name718/drone/文档/桌面自平衡机器人2/图片/02-TB6612电机驱动模块.png

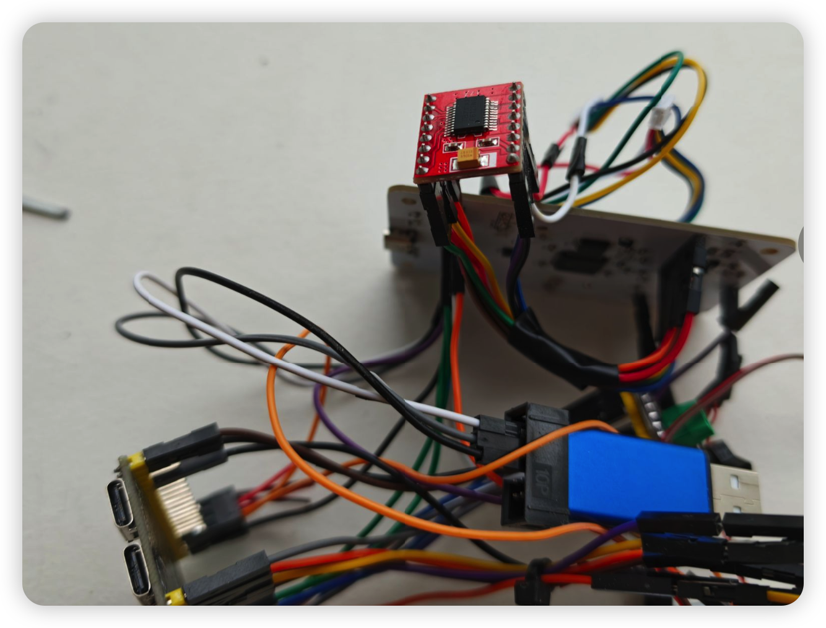
文档/桌面自平衡机器人2/图片/02-TB6612电机驱动模块.png
