name718/drone/文档/桌面自平衡机器人2/图片/05-N20编码器电机与主控板.png

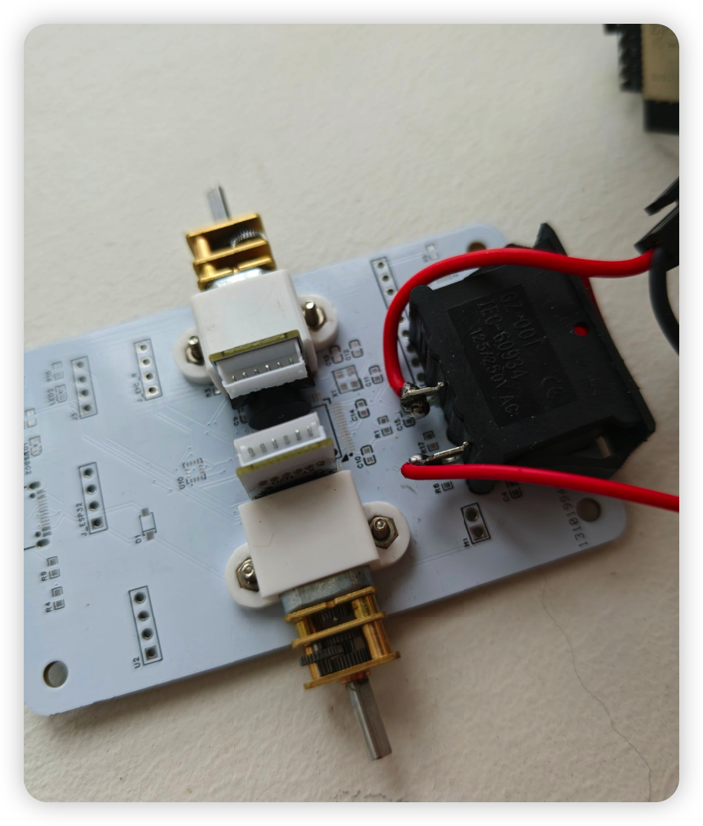
文档/桌面自平衡机器人2/图片/05-N20编码器电机与主控板.png
