name718/drone/文档/桌面自平衡机器人2/图片/README.md

# 硬件实物照片

| 文件 | 内容 |
| --- | --- |
| `01-硬件全景.png` | 当前硬件与接线整体照片 |
| `02-TB6612电机驱动模块.png` | TB6612 电机驱动模块及周边接线 |
| `03-LM2596降压模块.png` | LM2596 降压模块正面 |
| `04-ESP32-S3开发板.png` | ESP32-S3 双 USB-C 开发板 |
| `05-N20编码器电机与主控板.png` | N20 编码器电机、轮子和主控板局部 |
| `06-主控板及音频模块.png` | 主控板、排针模块及音频相关模块局部 |

照片用于器件识别和装配记录；由于拍摄角度和比例尺限制，不作为精确尺寸测量依据。
