name718/drone/代码文档/查缺补漏.md

# const_cast
# constexpr

# pdMS_TO_TICKS
> 作用是将人类习惯的“毫秒（ms）”时间转换为操作系统内核运行所用的“系统节拍数（Ticks）”。

# explicit

# I2S

# DMA

# using CommandCallback = std::function<void(VoiceCommand)>;
