name718/drone/文档/桌面自平衡机器人2/10-硬件尺寸总表.md

# 桌面自平衡机器人 2.0 硬件尺寸总表

> 更新日期：2026-10-17  
> 用途：集中记录 2.0 机械建模所需的硬件尺寸。单位均为 mm；“已确认”优先作为 CAD 输入，“待复核/待测”不可当作最终加工尺寸。

## 1. 已有尺寸

| 部件 | 尺寸 / 参数 | 来源与状态 | CAD 使用建议 |
| --- | --- | --- | --- |
| 橡胶车轮（白色轮毂、黑色胎） | 外径 Ø43.36；宽 17.64 | 游标卡尺实测 | 采用实测值；轮毂轴孔仍待测 |
| 2S 18650 电池组 | 71.60 × 37.30 × 22.10 | 游标卡尺实测 | 采用实测最大包络；托架每侧额外留 1.5–2.0 间隙；线束另留空间 |
| STM32 主控 PCB | 外形 53.987 × 85.587 × 1.600；四角圆弧约 R3.987 | STEP 文件 `3D_PCB1_2026-10-17.step` 中 PCB 本体实体 | 以 STEP 模型为准；外形可按 53.99 × 85.59 × 1.60 建模 |
| STM32 主控 PCB 安装孔 | 4 × Ø3.200；中心坐标约 (5.00, 4.00)、(50.00, 4.00)、(5.00, 81.60)、(50.00, 81.60)；孔距 45.00 × 77.60；中心距板边约 4.00 | 同一 STEP 文件；相对板框坐标，原点方向依导出坐标系 | 以孔距和边距定位支柱；建模前核实 STEP 的坐标原点/板边方向 |
| 主控 PCB 元件总包络 | STEP 全模型包围范围约 X 66.69 × Y 96.57 × Z 15.61 | STEP 所有几何点的总体范围，包含外伸连接器/引脚及器件模型 | 仅用于装配净空参考，不作为裸 PCB 尺寸；边缘插头需额外留插拔空间 |
| 主控 PCB 标准排针 | 2.54 间距；J2 为 1×10；J_ENC_L、J_ENC_R、J_ESP32、J3 为 1×4 | PCB 坐标导出文本与 STEP 模型 | 针位已知；排针总高度与配套插头外形尚未核实 |
| 船型电源开关 KCD1 / GZ-001 | 面板外框 31.20 × 13.70 | 游标卡尺实测 | 该值不是面板开孔尺寸；开孔和背部深度待测 |
| N20 电机支架 | 外宽 17.20；纵深约 11–12；高度约 14.50；单支架孔中心距约 17.50–18.00；左右支架横向跨度约 39.50 | 外宽、跨度为用户实测；其他为标准件参考/照片估算 | CAD 可暂用 18.00 孔距；打印/加工前需复测孔距、孔径、纵深、高度和电机轴中心高度 |
| N20 编码器减速电机（图示 12GA-N20 套装） | 标准 N20 齿轮箱正面约 **12 × 10 mm**；电机+齿轮箱本体长度随减速比/尾盖变化，常见约 **26–32 mm**；编码器尾板另增加约 **5–10 mm**；输出轴常见 Ø3 mm D 轴 | 图片确认是 12GA-N20 带编码器套装；12GA 是商品/套装名，不足以唯一确定减速比和尾板尺寸 | 外宽可参考 12 × 10；总长及轴伸出没有该商品工程图，不能用单一数值冻结 |
| N20 配套轮毂 | 项目轮胎实测 Ø43.36 × 17.64；配套轮常见 3 mm D 轴孔，但轮毂深度/偏置随白色轮毂版本变化 | 图片能确认白色轮毂配黑胎；未提供轴孔尺寸图或比例尺 | 外形采用实测；轴孔“3 mm D 孔”仅作候选，孔深和偏置目前仍未知 |
| TB6612FNG 双路电机驱动模块（红色小板） | 照片可确认红色 TB6612FNG breakout 类型；同芯片载板有约 **20 × 20 mm** 到 **25 × 20 mm** 等多种板框，芯片本身封装约 **9.7 × 6.4 mm** | 图片没有可辨识的板号/商品型号；裸芯片封装尺寸可查，载板尺寸不统一 | 不将通用载板尺寸当作本板尺寸；板框、孔位和板厚需要对应卖家图纸或实物卡尺值 |
| ESP32-S3 双 USB-C 开发板 | 图片显示双 USB-C 的 ESP32-S3 DevKitC 类板；官方 DevKitC-1 PCB 参考外形约 **55 × 28 mm**、PCB 厚约 1.6 mm | 图片可辨识双 USB-C 板型家族，但不能确认是 Espressif 官方板还是兼容板 | 官方 DevKitC-1 数值只作近似参考；兼容板 USB 外壳/板边可能不同，孔位不可直接套用 |
| Luckfox Pico Mini A/B（RV1103） | 官方 Pico Mini 板型约 **30 × 30 mm** | 商品图确认 Pico Mini A/B、RV1103；官方系列板型资料 | PCB 外形可按 30 × 30 mm 参考；板厚、焊接排针总高、接口凸出和安装孔依实际版本确认 |
| OV5640 自动对焦 DVP 模块（蓝色 Gravity 类板） | 同类 Gravity 板常见约 **32 × 32 mm**；镜头模组直径约 **8–10 mm**，镜头高度依焦距/对焦座版本变化 | 图片确认是蓝色 Gravity 风格 OV5640 自动对焦模块；没看到商品机械图，镜头版本不唯一 | 32 × 32 mm 仅为板框参考；本图两个安装孔、光轴偏置、镜头高度不能从无比例尺照片量准 |
| SG90 双自由度云台套件 | 标准 SG90 舵机本体常见约 **23 × 12.2 × 29 mm**；图示云台含两个舵机、底座和塑料支架，整套总包络没有统一尺寸 | 图片确认是 9g SG90 pan-tilt 套件；不同商家支架版本不同 | 舵机本体可参考标准尺寸；云台支架总长宽高/底孔距不从相似商品推定 |
| ST7735S 1.8 英寸 TFT 模块 | 1.8 英寸 128×160 屏的有效显示区约 **28.0 × 35.0 mm**；模块 PCB 常见外框存在约 **35 × 35 mm**、**35 × 50 mm** 等不同版本 | 项目记录确认 1.8 英寸 ST7735S；实物照显示屏装在白色承载板/总成中，无法从照片分离出屏模块 PCB 外框 | 显示区按分辨率/对角规格参考；模块板框、厚度、孔位和排针朝向必须按实际模块图纸确认 |
| LM2596 类降压模块 | PCB 长 56.80 × 宽 23.80 | 游标卡尺实测 | 板面占位可先采用；最高元件高度、安装孔位、端子/电位器净空待测 |

## 2. 尚缺的尺寸

| 部件 | 需要补充的测量项 | 用途 / 优先级 |
| --- | --- | --- |
| N20 电机本体 | 网上已有 N20 参考包络；仍需核对本批次总长、输出轴伸出量、轴中心高度、编码器尾部和左右一致性 | 高：网上尺寸可作初版，实物决定最终配合 |
| 车轮 | 网上常见 3 mm D 孔；仍需核对本轮毂孔径、D 轴平面尺寸/孔深和轮毂偏置 | 高：确认轴适配和轮距 |
| N20 支架 | 安装孔实际孔径、中心距、支架纵深和高度、板厚/折弯尺寸 | 高：锁定电机安装孔 |
| 电池组 | 插头及平衡线从电池壳体伸出后的方向、总长度；保护板或壳体局部凸起 | 高：电池托架与线束净空 |
| 主控 PCB | STEP 坐标中 USB-C/排针插接方向；线束和插头插拔空间 | 中高：确保装好后可维护 |
| LM2596 模块 | 安装孔中心坐标/孔径；最大高度；端子、散热片、电位器突出尺寸 | 中高：确定托板与固定方式 |
| TB6612FNG 模块 | 红色载板尺寸没有通用标准；需要对应商品图纸或实物板框、板厚、排针高度 | 中：照片只能确认芯片/载板类别 |
| ESP32-S3 开发板 | 官方 DevKitC-1 有约 55 × 28 mm 参考；仍需确认照片中兼容板的板框、排针总高和 USB 凸出 | 中：实际板型未由照片唯一确定 |
| ST7735S 屏幕 | 1.8 英寸有效显示区约 28 × 35 mm；实际 PCB 板框/厚度/孔位依模块版本 | 中：实物照无法分离显示模块与白色承载板 |
| 双轴云台与 SG90 | SG90 本体网上已有 23 × 12.2 × 29 mm 参考；云台套件总长/总宽/总高、底板孔距、机械限位仍待确认 | 中高：头部活动包络及线束余量 |
| INMP441 / MAX98357A | 模块长宽厚、安装孔、排针高度和线缆方向 | 中：托板布局 |
| 3525 扬声器 | 外径、最大厚度、安装孔距/孔径、出线方向 | 中：头部开孔和固定 |
| OV5640 摄像头 | 同类 Gravity 板框约 32 × 32 mm 仅作参考；核实实际板框、镜头突出和孔位 | 高：照片无尺标，不能确定到具体尺寸 |
| Luckfox Pico Mini A/B | 官方约 30 × 30 mm 板框参考；核实厚度、排针高、接口凸出和具体版本 | 高：新增计算板安装 |
| VL53L0X（若纳入） | 模块板外形、安装孔和光学窗口位置 | 低：当前为待确认扩展件 |
| 船型开关 | 面板开孔尺寸、卡扣外形、允许板厚、背部深度 | 中：开关面板开孔 |
| 紧固件/尼龙柱 | 螺纹、杆长、头径/六角对边、螺母厚度、尼龙柱总长 | 中：装配间隙和层间距 |

## 3. 建模基准与注意事项

- 主控 PCB 所有外形和安装孔数据以 STEP 模型为准；此前卡尺记录的 85.40 × 49.00 mm 不作为 CAD 基准。
- PCB STEP 全模型包围盒包含元件和外伸结构，不能拿 66.69 × 96.57 mm 作为板框尺寸。
- 电池托架依据实测最大包络建模；电池导线、插头、平衡线不包含在 71.60 × 37.30 × 22.10 mm 中。
- 支架 18 mm 孔距当前是近似值。正式打印前量孔中心距和孔径，并确认螺丝实际规格；不能只依据照片推算。
- 元件清单及安装状态见 [09-2.0升级方案与硬件建模测量清单](09-2.0升级方案与硬件建模测量清单.md)。暂停的四轴无人机尺寸资料不并入本表。

## 4. 网上规格参考入口

- N20：按 `12GA-N20 编码器减速电机`、`N20 gear motor mechanical drawing` 类目规格整理；减速比、编码器尾盖和轮子套装会改变总长。
- ESP32-S3：Espressif [ESP32-S3-DevKitC-1](https://docs.espressif.com/projects/esp-idf/en/latest/esp32/hw-reference/esp32s3/user-guide-devkitc-1.html) 机械外形作为官方板型参考。
- Luckfox：Luckfox [Pico Mini RV1103](https://wiki.luckfox.com/Luckfox-Pico/Luckfox-Pico-RV1103/) 系列资料作为板型参考。
- OV5640：按 `OV5640 DVP autofocus module` / Gravity 类模块商品机械尺寸整理；镜头和转接板不是统一标准件。
- SG90：按 TowerPro SG90/9g servo 通用机械尺寸整理；仿品外壳尺寸可能不同。
- ST7735S：按常见 `1.8 inch 128×160 ST7735S SPI module` 商品板型整理。
- TB6612FNG：按常见红色 breakout 模块整理；Pololu、SparkFun 和国产载板不是同一 PCB 尺寸。

## 5. 实测记录模板

```text
部件：
测量项：
数值（mm）：
测量位置/方向：
是否包含插头、排针、线束或凸出元件：
测量工具与备注：
```
