name718/drone/文档/桌面自平衡机器人/05-V1主控板原理图与全量网表规范.md

# 桌面双轮自平衡智能机器人主控板 · V1 原理图全量规范与引脚级网表

> **版本**：V1.0 (生产定稿版)  
> **对应图纸**：`桌面自平衡机器人/原理图/SCH_Schematic1_1-P1_2026-08-27.png`  
> **文档目的**：本规范以严格、结构化、无歧义的文字形式完整描述整张主控板原理图。包含**引脚级元件网表、全局网络连接清单、单片机外设映射字典与 PCB/固件开发规范**，可直接投喂给其他 AI Agent 进行 PCB 自动布线或嵌入式底层固件开发。

---

## 1. 硬件系统整体架构概述

```text
┌─────────────────────────────────────────────────────────────────────────────────┐
│                           2S 动力锂电池组 (7.4V ~ 8.4V)                         │
└────────┬───────────────────────────────────────────────────────┬────────────────┘
         │                                                       │
                                                               
┌──────────────────┐                                   ┌──────────────────┐
│ J1: 电池供电输入 │                                   │ 外部 LM2596S     │
└────────┬─────────┘                                   │ 降压模块 (6.0V)  │
         │ VBAT                                        └────────┬─────────┘
         ├───────────────────────┬──────────────────┐           │ VM_6V
                                                          
┌──────────────────┐   ┌──────────────────┐   ┌───────────────────────────────────┐
│ U11: SY8120IABC  │   │ 电池分压采样     │   │ H1 / J_TB: 动力驱动接口 (1x10P)   │
│ 2S降压DCDC (2A)  │   │ R8(10k)+R17(4.7k)│   │ • VM_6V 独立供电                   │
└────────┬─────────┘   └────────┬─────────┘   │ • TB6612FNG 双路 H 桥模块         │
         │ +5V                  │ BAT_SENSE   │ • 驱动 2 颗 N20 减速电机 (6V)     │
         ├───────────────┐      │ (0~2.68V)   └───────────────────────────────────┘
         │               │                                     
                       │   ┌───────────────────────────────┐   │ PWM/DIR/STBY
┌──────────────────┐     │   │                               │───┘
│ LDO2: ME6211C33  │     │   │    U9: STM32G473RCT6 主控     │
│ 5V 转 3.3V (LDO) │     │   │   (LQFP-64, 170MHz Cortex-M4) │───┐
└────────┬─────────┘     │   │                               │   │
         │ +3V3          │   └──────┬─────────────────┬──────┘   │
                                │ SPI1            │ SPI2     │
┌──────────────────────────────┐                             │
│ • U9 STM32G473 单片机电源    │ ┌──────────────┐ ┌────────────┐ │
│ • U10 ICM-42605 6轴陀螺仪    │ │ U10: 6轴 IMU │ │ U13: Flash │ │
│ • U13 W25Q128 Flash 存储器   │ │  ICM-42605   │ │  W25Q128   │ │
│ • J_ENC_L/R 左右轮霍尔编码器 │ └──────────────┘ └────────────┘ │
│ • USBC2 Type-C 与 SWD 调试口 │                                 │
└──────────────────────────────┘                                 │
                                                               │
         │ USB_VBUS (通过 D1 肖特基二极管供电)                   │ USART2 串口
         │                                                       
┌──────────────────┐                                   ┌──────────────────┐
│ USBC2: Type-C 口 │                                   │ J_ESP32: AI 大脑 │
│ 电脑插线调试/下载│                                   │ ESP32-S3 智能板  │
└──────────────────┘                                   └──────────────────┘
```

---

## 2. 芯片级引脚连接与网表定义 (Pin-to-Net Definition)

### 2.1 U9：主控 MCU (STM32G473RCT6, LQFP-64)

| 引脚编号 | 引脚名称 | 连接网络 (Net Name) | 硬件外设功能 / 目标连接 |
| :---: | :--- | :--- | :--- |
| **1** | `VBAT` | `+3V3` | 备用电源域供电，接系统 3.3V |
| **2** | `PC13` | `LED_STATUS` | 用户状态指示灯（低电平点亮蓝色 LED2） |
| **3** | `PC14-OSC32_IN` | `NC` (打叉) | 未使用，悬空隔离 |
| **4** | `PC15-OSC32_OUT`| `NC` (打叉) | 未使用，悬空隔离 |
| **5** | `PF0-OSC_IN` | `PF0-OSC_IN` | 8MHz 主晶振输入端，接 X1 第 1 脚及 C12 (15pF) |
| **6** | `PF1-OSC_OUT` | `PF1-OSC_OUT` | 8MHz 主晶振输出端，接 X1 第 3 脚及 C13 (15pF) |
| **7** | `PG10-NRST` | `NRST` 节点 | 硬件复位：接 R1 (10k 上拉到 +3V3) 及 C14 (100nF 到 GND) |
| **8** | `PC0` | `BAT_SENSE` | ADC1 通道，采集电池分压（10k + 4.7k 分压点） |
| **9** | `PC1` | `NC` (打叉) | 未使用，悬空隔离 |
| **10** | `PC2` | `NC` (打叉) | 未使用，悬空隔离 |
| **11** | `PC3` | `NC` (打叉) | 未使用，悬空隔离 |
| **12** | `PA0` | `ENC_L_A` | TIM2_CH1：左轮霍尔编码器 A 相输入 |
| **13** | `PA1` | `ENC_L_B` | TIM2_CH2：左轮霍尔编码器 B 相输入 |
| **14** | `PA2` | `STM_TX` | USART2_TX：串口发送至 ESP32-S3 (RX) |
| **15** | `VSS` | `GND` | 数字地 1 |
| **16** | `VDD` | `+3V3` | 数字核心供电 1，就近放 100nF 去耦电容 |
| **17** | `PA3` | `STM_RX` | USART2_RX：串口接收来自 ESP32-S3 (TX) |
| **18** | `PA4` | `IMU_CS` | SPI1_NSS：ICM-42605 陀螺仪片选信号 (片选有效为低) |
| **19** | `PA5` | `IMU_SCK` | SPI1_SCK：ICM-42605 陀螺仪时钟线 |
| **20** | `PA6` | `IMU_MISO` | SPI1_MISO：ICM-42605 陀螺仪数据输入 |
| **21** | `PA7` | `IMU_MOSI` | SPI1_MOSI：ICM-42605 陀螺仪数据输出 |
| **22** | `PC4` | `IMU_INT1` | EXTI4：ICM-42605 姿态数据就绪硬件中断引脚 |
| **23** | `PC5` | `NC` (打叉) | 未使用，悬空隔离 |
| **24** | `PB0` | `MOTOR_BIN2` | GPIO 输出：右轮电机方向控制信号 2 |
| **25** | `PB1` | `MOTOR_STBY` | GPIO 输出：TB6612 驱动使能信号（带 10k 下拉到 GND） |
| **26** | `PB2` | `NC` (打叉) | 未使用，悬空隔离 |
| **27** | `VSSA` | `GND` | 模拟地 |
| **28** | `VREF+` | `+3V3` | ADC 模拟参考电压正极 |
| **29** | `VDDA` | `+3V3` | 模拟供电正极，放 100nF 去耦电容 |
| **30** | `PB10` | `NC` (打叉) | 未使用，悬空隔离 |
| **31** | `VSS` | `GND` | 数字地 2 |
| **32** | `VDD` | `+3V3` | 数字核心供电 2，放 100nF 去耦电容 |
| **33** | `PB11` | `NC` (打叉) | 未使用，悬空隔离 |
| **34** | `PB12` | `FLASH_CS` | SPI2_NSS：W25Q128 Flash 芯片片选信号 |
| **35** | `PB13` | `FLASH_SCK` | SPI2_SCK：W25Q128 Flash 时钟线 |
| **36** | `PB14` | `FLASH_MISO` | SPI2_MISO：W25Q128 Flash 数据输入 |
| **37** | `PB15` | `FLASH_MOSI` | SPI2_MOSI：W25Q128 Flash 数据输出 |
| **38** | `PC6` | `MOTOR_PWMA` | TIM3_CH1 / TIM8_CH1：左轮电机 PWM 调速输出 |
| **39** | `PC7` | `MOTOR_PWMB` | TIM3_CH2 / TIM8_CH2：右轮电机 PWM 调速输出 |
| **40** | `PC8` | `MOTOR_AIN1` | GPIO 输出：左轮电机方向控制信号 1 |
| **41** | `PC9` | `MOTOR_AIN2` | GPIO 输出：左轮电机方向控制信号 2 |
| **42** | `PA8` | `ENC_R_A` | TIM1_CH1：右轮霍尔编码器 A 相输入 |
| **43** | `PA9` | `ENC_R_B` | TIM1_CH2：右轮霍尔编码器 B 相输入 |
| **44** | `PA10` | `NC` (打叉) | 未使用，悬空隔离 |
| **45** | `PA11` | `USB_DM` | USB_FS_DM：Type-C USB 数据负端 |
| **46** | `PA12` | `USB_DP` | USB_FS_DP：Type-C USB 数据正端 |
| **47** | `VSS` | `GND` | 数字地 3 |
| **48** | `VDD` | `+3V3` | 数字核心供电 3，放 100nF 去耦电容 |
| **49** | `PA13` | `SWDIO` | SWD 调试数据线，接 U2 烧录排针第 2 脚 |
| **50** | `PA14` | `SWCLK` | SWD 调试时钟线，接 U2 烧录排针第 3 脚 |
| **51** | `PA15` | `MOTOR_BIN1` | GPIO 输出：右轮电机方向控制信号 1 |
| **52** | `PC10` | `NC` (打叉) | 未使用，悬空隔离 |
| **53** | `PC11` | `NC` (打叉) | 未使用，悬空隔离 |
| **54** | `PC12` | `NC` (打叉) | 未使用，悬空隔离 |
| **55** | `PD2` | `NC` (打叉) | 未使用，悬空隔离 |
| **56** | `PB3` | `NC` (打叉) | 未使用，悬空隔离 |
| **57** | `PB4` | `NC` (打叉) | 未使用，悬空隔离 |
| **58** | `PB5` | `NC` (打叉) | 未使用，悬空隔离 |
| **59** | `PB6` | `NC` (打叉) | 未使用，悬空隔离 |
| **60** | `PB7` | `NC` (打叉) | 未使用，悬空隔离 |
| **61** | `PB8-BOOT0`| `BOOT0` 节点 | 启动模式配置：接 R3 (10k 下拉到 GND) 默认 Flash 启动 |
| **62** | `PB9` | `NC` (打叉) | 未使用，悬空隔离 |
| **63** | `VSS` | `GND` | 数字地 4 |
| **64** | `VDD` | `+3V3` | 数字核心供电 4，放 100nF 去耦电容 |

---

### 2.2 U10：ICM-42605 六轴姿态传感器 (LGA-14)

| 引脚编号 | 引脚名称 | 连接网络 | 连接说明 |
| :---: | :--- | :--- | :--- |
| **1** | `AP_SDO/AP_AD0` | `IMU_MISO` | SPI 主机输入，接 STM32 PA6 (20脚) |
| **2, 3, 7** | `RESV` | `NC` (打叉) | 内部保留引脚，悬空 |
| **4** | `INT1/INT` | `IMU_INT1` | 姿态数据就绪中断，接 STM32 PC4 (22脚) |
| **5** | `VDDIO` | `+3V3` | 数字 I/O 供电，就近放 100nF 到 GND |
| **6** | `GND` | `GND` | 芯片接地 |
| **8** | `VDD` | `+3V3` | 模拟/核心供电，就近放 100nF 到 GND |
| **9** | `INT2/FSYNC` | `NC` (打叉) | 未使用，悬空 |
| **10, 11** | `RESV` | `NC` (打叉) | 内部保留引脚，悬空 |
| **12** | `AP_CS` | `IMU_CS` | SPI 片选输入，接 STM32 PA4 (18脚) |
| **13** | `AP_SCL/AP_SCLK`| `IMU_SCK` | SPI 时钟输入，接 STM32 PA5 (19脚) |
| **14** | `AP_SDA/...` | `IMU_MOSI` | SPI 主机输出，接 STM32 PA7 (21脚) |

---

### 2.3 U13：W25Q128JVSIQ 16MB 外部 Flash 存储器 (SOIC-8)

| 引脚编号 | 引脚名称 | 连接网络 | 连接说明 |
| :---: | :--- | :--- | :--- |
| **1** | `CS#` | `FLASH_CS` | SPI 片选，接 STM32 PB12 (34脚) |
| **2** | `DO` | `FLASH_MISO` | SPI 数据输出，接 STM32 PB14 (36脚) |
| **3** | `IO2` | `NC` (打叉) | 标准 SPI 模式悬空 |
| **4** | `GND` | `GND` | 芯片接地 |
| **5** | `DI` | `FLASH_MOSI` | SPI 数据输入，接 STM32 PB15 (37脚) |
| **6** | `CLK` | `FLASH_SCK` | SPI 时钟输入，接 STM32 PB13 (35脚) |
| **7** | `IO3` | `NC` (打叉) | 标准 SPI 模式悬空 |
| **8** | `VCC` | `+3V3` | 芯片供电，就近放 100nF 到 GND |

---

### 2.4 电源系统：U11 (SY8120IABC) 与 LDO2 (ME6211)

#### 1. U11：SY8120IABC 同步降压 DCDC (SOT-23-6)
* **1 脚 (BS)**：通过 **C2 (100nF 自举电容)** 跨接到 **6 脚 (LX)**；
* **2 脚 (GND)**：接 **`GND`**；
* **3 脚 (FB)**：接反馈分压中点（**R7 110k 接 +5V**，**R2 15k 接 GND**，分压计算公式：$V_{OUT} = 0.6\text{V} \times (1 + \frac{110\text{k}}{15\text{k}}) = 5.0\text{V}$）；
* **4 脚 (EN)**：接 **`VBAT`**（开启使能）；
* **5 脚 (IN)**：接 **`VBAT`**，输入端挂 **C8 (10uF) 到 GND**；
* **6 脚 (LX)**：串联 **L1 (4.7uH 功率电感)** 到 **`+5V`**，输出端挂 **C1 (10uF) 与 C3 (100nF) 到 GND**。

#### 2. LDO2：ME6211C33M5G-N 3.3V 稳压器 (SOT-23-5)
* **1 脚 (VIN)**：接 **`+5V`**，输入端挂 **C4 (10uF) 到 GND**；
* **2 脚 (VSS)**：接 **`GND`**；
* **3 脚 (CE)**：接 **`+5V`**（高电平使能）；
* **4 脚 (NC)**：打叉悬空；
* **5 脚 (VOUT)**：输出 **`+3V3`**，输出端挂 **C5 (10uF) 与 C6 (100nF) 到 GND**。

---

### 2.5 接口插座定义与引脚分配

| 连接器标号 | 封装类型 | 引脚 1 | 引脚 2 | 引脚 3 | 引脚 4 | 引脚 5 | 引脚 6 | 引脚 7 | 引脚 8 | 引脚 9 | 引脚 10 |
| :--- | :--- | :--- | :--- | :--- | :--- | :--- | :--- | :--- | :--- | :--- | :--- |
| **J1 (电池输入)** | 1x2P 2.54mm | `VBAT` | `GND` | — | — | — | — | — | — | — | — |
| **H1 (6V动力输入)**| 1x2P 2.54mm | `VM_6V` | `GND` | — | — | — | — | — | — | — | — |
| **J_TB (电机驱动)**| 1x10P 2.54mm| `VM_6V` | `+3V3` | `GND` | `MOTOR_PWMA` | `MOTOR_AIN1` | `MOTOR_AIN2` | `MOTOR_PWMB` | `MOTOR_BIN1` | `MOTOR_BIN2` | `MOTOR_STBY` (带10k下拉) |
| **J_ENC_L (左编码)**| 1x4P 2.54mm | `+3V3` | `GND` | `ENC_L_A` | `ENC_L_B` | — | — | — | — | — | — |
| **J_ENC_R (右编码)**| 1x4P 2.54mm | `+3V3` | `GND` | `ENC_R_A` | `ENC_R_B` | — | — | — | — | — | — |
| **J_ESP32 (AI大脑)**| 1x4P 2.54mm | `+5V` | `GND` | `STM_TX` | `STM_RX` | — | — | — | — | — | — |
| **U2 (SWD 烧录)** | 1x4P 2.54mm | `+3V3` | `SWDIO` | `SWCLK` | `GND` | — | — | — | — | — | — |

---

### 2.6 USBC2、晶振、LED 及分压采样电路

1. **USBC2 (TYPE-C-31-M-12)**：
   * `A1B12, B1A12, EH1~4` $\to$ **`GND`**；
   * `A4B9, B4A9` $\to$ **`USB_VBUS`**（经 **D1 肖特基二极管 B5819W** 单向导通至 **`+5V`**）；
   * `A5 (CC1)` $\to$ 经 **R9 (5.1k)** 接 **`GND`**；
   * `B5 (CC2)` $\to$ 经 **R4 (5.1k)** 接 **`GND`**；
   * `A6, B6 (DP)` $\to$ **`USB_DP`** (接 PA12)；
   * `A7, B7 (DN)` $\to$ **`USB_DM`** (接 PA11)；
   * `A8, B8 (SBU)` $\to$ 悬空打叉。
2. **X1 (8MHz 无源晶振)**：
   * `1 脚` $\to$ **`PF0-OSC_IN`**（并联 **C12 15pF 到 GND**）；
   * `3 脚` $\to$ **`PF1-OSC_OUT`**（并联 **C13 15pF 到 GND**）；
   * `2 脚, 4 脚` $\to$ **`GND`**（金属屏蔽外壳接地）。
3. **指示灯电路**：
   * **LED1 (电源绿灯)**：`+3V3` $\to$ **R6 (1k)** $\to$ **KT-0603G 阳极** $\to$ 阴极接 **`GND`**；
   * **LED2 (运行蓝灯)**：`+3V3` $\to$ **R10 (1k)** $\to$ **KT-0603B 阳极** $\to$ 阴极挂 **`LED_STATUS`** (接 PC13)。
4. **BAT_SENSE (电池分压采样)**：
   * `VBAT` $\to$ **R8 (10k)** $\to$ `中点 BAT_SENSE` (接 PC0) $\to$ **R17 (4.7k)** $\to$ `GND`；
   * 中点并联 **C15 (100nF)** 到 `GND` 滤波。
   * 满电 8.4V 采样计算：$V_{ADC} = 8.4\text{V} \times \frac{4.7}{10 + 4.7} = 2.685\text{V}$。

---

## 3. 固件开发人员快速外设映射字典 (Firmware Pin Map)

```c
/**
 * @brief STM32G473RCT6 桌面自平衡小车底层引脚与外设映射
 */

// 1. 电机驱动与调速 (TB6612FNG)
#define MOTOR_L_PWM_PIN       GPIO_PIN_6   // PC6 (TIM3_CH1 / TIM8_CH1)
#define MOTOR_L_PWM_PORT      GPIOC
#define MOTOR_R_PWM_PIN       GPIO_PIN_7   // PC7 (TIM3_CH2 / TIM8_CH2)
#define MOTOR_R_PWM_PORT      GPIOC

#define MOTOR_L_IN1_PIN       GPIO_PIN_8   // PC8 (GPIO_OUT)
#define MOTOR_L_IN1_PORT      GPIOC
#define MOTOR_L_IN2_PIN       GPIO_PIN_9   // PC9 (GPIO_OUT)
#define MOTOR_L_IN2_PORT      GPIOC

#define MOTOR_R_IN1_PIN       GPIO_PIN_15  // PA15 (GPIO_OUT)
#define MOTOR_R_IN1_PORT      GPIOA
#define MOTOR_R_IN2_PIN       GPIO_PIN_0   // PB0 (GPIO_OUT)
#define MOTOR_R_IN2_PORT      GPIOB

#define MOTOR_STBY_PIN        GPIO_PIN_1   // PB1 (GPIO_OUT, High Enable)
#define MOTOR_STBY_PORT       GPIOB

// 2. 左右轮正交编码器测速 (AB相)
#define ENC_L_TIM             TIM2         // 32-bit Timer Encoder Mode
#define ENC_L_A_PIN           GPIO_PIN_0   // PA0 (TIM2_CH1)
#define ENC_L_B_PIN           GPIO_PIN_1   // PA1 (TIM2_CH2)

#define ENC_R_TIM             TIM1         // Advanced Timer Encoder Mode
#define ENC_R_A_PIN           GPIO_PIN_8   // PA8 (TIM1_CH1)
#define ENC_R_B_PIN           GPIO_PIN_9   // PA9 (TIM1_CH2)

// 3. 姿态传感器 ICM-42605 (SPI1 + EXTI)
#define IMU_SPI               SPI1
#define IMU_CS_PIN            GPIO_PIN_4   // PA4 (SPI1_NSS / GPIO_OUT)
#define IMU_SCK_PIN           GPIO_PIN_5   // PA5 (SPI1_SCK)
#define IMU_MISO_PIN          GPIO_PIN_6   // PA6 (SPI1_MISO)
#define IMU_MOSI_PIN          GPIO_PIN_7   // PA7 (SPI1_MOSI)
#define IMU_INT_PIN           GPIO_PIN_4   // PC4 (EXTI4 中断)

// 4. 外部存储 W25Q128 (SPI2)
#define FLASH_SPI             SPI2
#define FLASH_CS_PIN          GPIO_PIN_12  // PB12 (SPI2_NSS / GPIO_OUT)
#define FLASH_SCK_PIN         GPIO_PIN_13  // PB13 (SPI2_SCK)
#define FLASH_MISO_PIN        GPIO_PIN_14  // PB14 (SPI2_MISO)
#define FLASH_MOSI_PIN        GPIO_PIN_15  // PB15 (SPI2_MOSI)

// 5. ESP32-S3 通信串口 (USART2, 115200 / 921600 bps)
#define HOST_UART             USART2
#define HOST_TX_PIN           GPIO_PIN_2   // PA2 (USART2_TX)
#define HOST_RX_PIN           GPIO_PIN_3   // PA3 (USART2_RX)

// 6. 电池电压采样 ADC (ADC1_IN6)
#define BAT_ADC_CHANNEL       ADC_CHANNEL_6 // PC0
#define BAT_DIVIDER_RATIO     (14.7f / 4.7f) // 3.127659f

// 7. 用户状态指示灯 (LED2)
#define LED_STATUS_PIN        GPIO_PIN_13  // PC13 (Low Active)
#define LED_STATUS_PORT       GPIOC
```

---

## 4. 全板 100% 完整 BOM 物料清单

| 序号 | 器件位号 | 型号/参数规格 | 封装名称 | 数量 | 作用说明 |
| :---: | :--- | :--- | :--- | :---: | :--- |
| 1 | `U9` | **STM32G473RCT6** | LQFP-64 (10x10mm) | 1 | 主控 MCU |
| 2 | `U10`| **ICM-42605** | LGA-14 (3x3mm) | 1 | 6 轴姿态传感器 |
| 3 | `U13`| **W25Q128JVSIQ** | SOIC-8 (208mil) | 1 | 16MB 外部 Flash |
| 4 | `U11`| **SY8120IABC** | SOT-23-6 | 1 | 2S 降压 DCDC 芯片 |
| 5 | `LDO2`| **ME6211C33M5G-N** | SOT-23-5 | 1 | 3.3V LDO 稳压器 |
| 6 | `X1` | **8MHz 无源晶振** | SMD-3225_4P | 1 | 系统外部高频时钟源 |
| 7 | `L1` | **4.7uH 功率电感** | 0806 / CD32 / 贴片 | 1 | DCDC 储能电感 |
| 8 | `D1` | **B5819W 肖特基二极管** | SOD-123 | 1 | USB 供电防倒灌 |
| 9 | `USBC2`| **TYPE-C-31-M-12** | 16Pin 贴片四脚插板 | 1 | Type-C 通信接口 |
| 10 | `LED1` | **KT-0603G (绿色 LED)** | 0603 贴片 | 1 | 3.3V 电源指示灯 |
| 11 | `LED2` | **KT-0603B (蓝色 LED)** | 0603 贴片 | 1 | PC13 运行状态指示灯 |
| 12 | `R1,R3,R5,R8` | **10kΩ 贴片电阻** | 0603 / 0402 | 4 | 上拉/下拉/采样分压 |
| 13 | `R7` | **110kΩ 贴片电阻** | 0603 / 0402 | 1 | DCDC 输出反馈上分压 |
| 14 | `R2` | **15kΩ 贴片电阻** | 0603 / 0402 | 1 | DCDC 输出反馈下分压 |
| 15 | `R4,R9` | **5.1kΩ 贴片电阻** | 0603 / 0402 | 2 | Type-C CC1/CC2 下拉 |
| 16 | `R17` | **4.7kΩ 贴片电阻** | 0603 / 0402 | 1 | 电池采样下分压 |
| 17 | `R6,R10` | **1kΩ 贴片电阻** | 0603 / 0402 | 2 | LED1/LED2 限流电阻 |
| 18 | `C1,C4,C5,C8` | **10uF 贴片陶瓷电容** | 0603 / 0805 | 4 | 电源滤波电容 |
| 19 | `C2,C3,C6,C7,C9,C10,C11,C14,C15` | **100nF 贴片电容** | 0603 / 0402 | 9 | 去耦与滤波电容 |
| 20 | `C12,C13` | **15pF 贴片电容** | 0603 / 0402 | 2 | 晶振起振匹配电容 |
| 21 | `J1, H1` | **2.54mm 1x2P 单排针/母** | 2.54mm 直插 | 2 | 电池与动力 6V 输入 |
| 22 | `U2, J_ESP32, J_ENC_L, J_ENC_R` | **2.54mm 1x4P 单排针/母** | 2.54mm 直插 | 4 | SWD/ESP32/左右编码器 |
| 23 | `J_TB` | **2.54mm 1x10P 单排针/母** | 2.54mm 直插 | 1 | TB6612 电机驱动插座 |
