name718/drone/文档/桌面自平衡机器人/08-全机实物最终接线总览与电气防烧指南.md

# 桌面双轮自平衡机器人 · 全机实物最终接线总览与电气规范

> **文档状态**：**全机实物外设 100% 验证通过**（STM32 底盘闭环 + ESP32 大脑彩屏/云台/麦克风/喇叭全部实测点亮）  
> **更新时间**：2026-10-02  
> **维护说明**：本文档为实机物理连线唯一标准基准，后续任何接线调整均以此为准。

---

## 1. 全机供电树与“四大防烧红线”

### 1.1 电源拓扑架构图
```text
【2S 动力锂电池】(7.4V ~ 8.4V)
  │
  ├──> [外部 LM2596 降压模块] ──稳压输出 6.12V──┬──> 主控板 H1 接口 ──> TB6612 [VM 动力引脚]
  │                                                └──> 两个 SG90 舵机 [红色正极 VCC]
  │
  └──> [主控板 J1 电池输入]
         │
         ├──> 板载 SY8120 DCDC ──输出 +5.0V──┬──> J_ESP32 接口 [Pin 1: +5V] (整车独立运行时供电)
         │                                    └──> 板载 ME6211 LDO ──输出 +3.3V──┬──> STM32G473 主控
         │                                                                       ├──> ICM-42605 陀螺仪
         │                                                                       ├──> 左右霍尔编码器
         │                                                                       └──> TB6612 [VCC 逻辑引脚]
         │
         └──> 电池采样电阻分压 (R8:10k + R17:4.7k) ──> STM32 [PC0 / ADC1] (实时电量监测)
```

### 1.2 绝对不可触碰的“四大防烧红线”
1. **INMP441 麦克风严禁接 5V**：其工作电压上限为 3.6V，**必须且只能接 ESP32 的 `3.3V`**，误接 5V 会瞬间击穿烧毁！
2. **MAX98357A 功放严禁接 6.12V 动力电**：功放芯片耐压上限 5.5V，**必须接 ESP32 的 `5V`（或 3.3V）**，绝不可接到 LM2596 的 6V 动力端！
3. **SG90 舵机供电严禁接 ESP32 板载排针**：两个舵机堵转电流峰值超过 1.2A，直接插 ESP32 排针会导致 ESP32 瞬间欠压反复重启甚至烧板载 LDO，**必须接 LM2596 输出端（6.0V ~ 6.12V）**！
4. **调试阶段防电源倒灌**：当 ESP32 使用 Type-C 连电脑调试时，**切勿将主控板 J_ESP32 的 5V 杜邦线插到 ESP32 的 5V 上**（防止电脑 USB 与主控 DCDC 电源倒灌短路冲突）。

---

## 2. 上位机（ESP32-S3 大脑）完整接线表

开发板型号：**ESP32-S3-DevKitC-1 (N16R8, 16MB Flash + 8MB Octal PSRAM)**

### 2.1 1.8寸 TFT 彩色液晶屏 (ST7735S 驱动, 128×160 分辨率)
> 使用 ESP32-S3 硬件 SPI2 总线驱动，已集成黑客帝国赛博电子眼与实时音频 VU 电平跳动条。

| TFT 屏幕引脚 | ESP32-S3 引脚 | 信号定义 | 功能说明 | 实测状态 |
| :--- | :--- | :--- | :--- | :---: |
| **GND** | **`GND`** | 电源地 | 信号地与电源参考 | 正常 |
| **VCC** | **`3.3V`** 或 **`5V`** | 电源输入 | 屏幕背光与芯片供电 | 正常 |
| **SCL / SCLK** | **`GPIO 12`** | SPI2_CLK | SPI 硬件时钟 | 正常 |
| **SDA / MOSI** | **`GPIO 11`** | SPI2_MOSI | SPI 硬件主出从入数据线 | 正常 |
| **RES / RST** | **`GPIO 10`** | GPIO_OUT | 硬件复位引脚 (低电平复位) | 正常 |
| **DC** | **`GPIO 13`** | GPIO_OUT | 数据 / 命令切换选择线 | 正常 |
| **CS** | **`GPIO 14`** | GPIO_OUT | SPI 硬件片选线 (低电平有效) | 正常 |
| **BLK / LED** | **`GPIO 21`** | GPIO_OUT | 背光使能 (高电平点亮背光) | 正常 |

---

### 2.2 双轴云台舵机 (SG90, 50Hz PWM 控制)
> 负责头部俯仰与左右摇头，平滑巡航与视觉追踪互动。

| 舵机轴向 | 舵机信号线 (黄色/橙色) | 舵机电源正 (红色) | 舵机电源负 (棕色/黑色) | 控制参数与范围 |
| :--- | :--- | :--- | :--- | :--- |
| **水平旋转 (Pan)** | **`GPIO 1`** (LEDC_CH0) | **LM2596 `OUT+` (6.0V)** | **LM2596 `OUT-` (GND)** | 0° ~ 180°，中位 90° |
| **垂直俯仰 (Tilt)** | **`GPIO 2`** (LEDC_CH1) | **LM2596 `OUT+` (6.0V)** | **LM2596 `OUT-` (GND)** | 45° ~ 135°，中位 90° |

---

### 2.3 扬声器 / 功放模块 (MAX98357A I2S 数字功放 + 3525 腔体喇叭)
> 使用 I2S1 通道，专职高保真音频输出、语音合成与声效自检。

| MAX98357A 引脚 | 目标引脚 | 信号定义 | 说明 |
| :--- | :--- | :--- | :--- |
| **Vin** | **ESP32 `5V`** (或 `VBUS`) | 电源输入 | 推荐 5V（声量充沛饱满，失真极低） |
| **GND** | **ESP32 `GND`** | 电源地 | 与主控板严格共地 |
| **DIN** | **`GPIO 15`** | I2S1_DATA_OUT | 串行音频 PCM 数据流 |
| **BCLK** | **`GPIO 16`** | I2S1_BCK | 位时钟信号 |
| **LRC** | **`GPIO 17`** | I2S1_WS / LRCK | 声道左右帧时钟 |
| **GAIN** | **悬空 (NC)** | 增益配置 | 内部上拉默认 9dB（动态极佳） |
| **SD / SD_MODE** | **悬空 (NC)** | 模式选择 | 默认使能，输出 (L+R)/2 单声道 |
| **螺丝接线端子** | **3525 腔体喇叭两根线** | 模拟驱动 | 红黑线分别插入螺丝端子拧紧即可 |

---

### 2.4 声音采集模块 (INMP441 全向数字 MEMS 麦克风)
> 使用 I2S0 通道，专职 16kHz 语音识别、拍手声控与声波 VU 表。

| INMP441 引脚 | ESP32-S3 引脚 | 信号定义 | 关键提示 |
| :--- | :--- | :--- | :--- |
| **VDD** | **`3.3V`** | 芯片供电 | **绝对禁止接 5V！否则芯片必烧！** |
| **GND** | **`GND`** | 电源地 | 信号参考地 |
| **SD** | **`GPIO 4`** | I2S0_DATA_IN | 录音串行数据输入 |
| **WS** | **`GPIO 5`** | I2S0_WS / LRCK | 字选择帧时钟 |
| **SCK** | **`GPIO 6`** | I2S0_BCK / SCLK | 位时钟输入 |
| **L/R** | **`GND`** | 声道配置 | 接地固定为左声道输出 |

---

### 2.5 大脑 -> 底盘通信总线 (UART2 跨芯片通信)
> 50Hz 周期性下发速度目标帧，双向心跳监控与遥测。

| ESP32-S3 引脚 | 底盘 STM32 主控引脚 | 信号类型 | 功能说明 |
| :--- | :--- | :--- | :--- |
| **`GPIO 7` (TX)** | **`PA3` (USART2_RX)** | 3.3V TTL | 大脑下发速度/转向/控制指令 |
| **`GPIO 8` (RX)** | **`PA2` (USART2_TX)** | 3.3V TTL | 底盘上报姿态角/编码器里程/电池电压 |
| **`GND`** | **`GND`** | 信号参考地 | 确保两块芯片电平基准绝对一致 |

> **注**：原计划使用的 GPIO 43/44 为 ESP32-S3 板载 Type-C USB-to-UART 硬件直连引脚。为避免开发时与电脑串口烧录/打印产生电平冲突，通信口已无缝迁移至 **`GPIO 7 (TX)` 和 `GPIO 8 (RX)`**。

---

## 3. 下位机（STM32G473RCT6 底盘）完整接线表

### 3.1 动力与主供电输入端子
- **`J1` (2Pin 电池端子)**：
  - 引脚 1（方孔/红线）：`VBAT`（2S 锂电池 7.4V ~ 8.4V）
  - 引脚 2（圆孔/黑线）：`GND`（电池负极共地）
- **`H1` (2Pin 动力端子)**：
  - 引脚 1（方孔/红线）：`VM_6V`（接 LM2596 输出的正 6.12V）
  - 引脚 2（圆孔/黑线）：`GND`（接 LM2596 输出的负 GND）

---

### 3.2 红色 TB6612 电机驱动板 -> 主控板 `J2` 接口 (10Pin 排母)
> 对应关系已通过电机正反转和 20kHz 硬件 PWM 验证。

| J2 引脚编号 | 主控板丝印/引脚 | TB6612 驱动板引脚 | 功能定义 |
| :---: | :--- | :--- | :--- |
| **1** | `VM_6V` | **`VM`** | 6.12V 电机动力输入 |
| **2** | `+3V3` | **`VCC`** | 3.3V 逻辑使能供电 |
| **3** | `GND` | **`GND`** | 公共地线 |
| **4** | `PC6` | **`PWMA`** | TIM3_CH1 / TIM8 电机 A 调速 PWM (20kHz) |
| **5** | `PC8` | **`AIN1`** | 电机 A 正转方向控制 |
| **6** | `PC9` | **`AIN2`** | 电机 A 反转方向控制 |
| **7** | `PC7` | **`PWMB`** | TIM3_CH2 / TIM8 电机 B 调速 PWM (20kHz) |
| **8** | `PA15` | **`BIN1`** | 电机 B 正转方向控制 |
| **9** | `PB0` | **`BIN2`** | 电机 B 反转方向控制 |
| **10** | `PB1` | **`STBY`** | 驱动芯片待机控制（高电平正常工作） |

---

### 3.3 左右 N20 减速电机动力线
- **左电机 (Motor A)**：
  - 白色端子线 -> TB6612 **`AO1`**
  - 红色端子线 -> TB6612 **`AO2`**
- **右电机 (Motor B)**：
  - 白色端子线 -> TB6612 **`BO1`**
  - 红色端子线 -> TB6612 **`BO2`**

---

### 3.4 左右轮高精度磁编码器接口
> 采用硬件正交解码模式，前进时两轮数值均严格正向递增。

#### 左轮编码器 (主控板 `J_ENC_L`, 4Pin):
1. **第 1 脚 (`+3V3`)**：**黑色线** (编码器电源正)
2. **第 2 脚 (`GND`)**：**蓝色线** (编码器地线)
3. **第 3 脚 (`ENC_L_A`)**：**绿色线** -> STM32 **`PA0`** (TIM2_CH1)
4. **第 4 脚 (`ENC_L_B`)**：**黄色线** -> STM32 **`PA1`** (TIM2_CH2)

#### 右轮编码器 (主控板 `J_ENC_R`, 4Pin):
1. **第 1 脚 (`+3V3`)**：**黑色线** (编码器电源正)
2. **第 2 脚 (`GND`)**：**蓝色线** (编码器地线)
3. **第 3 脚 (`ENC_R_A`)**：**绿色线** -> STM32 **`PA8`** (TIM1_CH1)
4. **第 4 脚 (`ENC_R_B`)**：**黄色线** -> STM32 **`PA9`** (TIM1_CH2)

---

### 3.5 板载六轴姿态传感器 (ICM-42605, SPI1 总线)
> 板载贴片芯片，无需外部接线，供查阅引脚映射：
- **`PA4`**：`IMU_CS`（片选，低有效）
- **`PA5`**：`IMU_SCK`（SPI1 时钟）
- **`PA6`**：`IMU_MISO`（SPI1 数据输入）
- **`PA7`**：`IMU_MOSI`（SPI1 数据输出）
- **`PC4`**：`IMU_INT1`（1000Hz 姿态数据就绪中断）

---

### 3.6 SWD 调试烧录接口 (`U2` / `J_SWD`, 4Pin)
> 连接 ST-Link V2 烧录器：
1. **`+3V3`**：接 ST-Link `3.3V`（目标板参考电压检测）
2. **`SWDIO`**：接 ST-Link `SWDIO`（STM32 `PA13`）
3. **`SWCLK`**：接 ST-Link `SWCLK`（STM32 `PA14`）
4. **`GND`**：接 ST-Link `GND`

---

## 4. 硬件模块自检结果总览

| 模块名称 | 所属芯片 | 实测测试项 | 实测结果 |
| :--- | :--- | :--- | :---: |
| **TB6612 电机驱动** | STM32G473 | 20kHz 硬件 PWM 双轮平稳正反转 | **通过** |
| **TIM1/TIM2 编码器** | STM32G473 | 硬件正交计数，向前推车数值单调递增 | **通过** |
| **ICM-42605 陀螺仪** | STM32G473 | 1000Hz DMA SPI 读取与 Mahony 姿态解算 | **通过** |
| **1.8寸 TFT 彩屏** | ESP32-S3 | 三原色刷新 + 赛博电子眼表情 + 音量 VU 表 | **通过** |
| **2-DOF SG90 云台** | ESP32-S3 | 50Hz LEDC 平滑巡航打哈欠与点头 | **通过** |
| **MAX98357A 喇叭** | ESP32-S3 | I2S1 DMA 播放经典马里奥过关旋律与提示音 | **通过** |
| **INMP441 麦克风** | ESP32-S3 | 16kHz I2S0 采集，声控拍手检测与跳动电平 | **通过** |
| **Wi-Fi 联网引擎** | ESP32-S3 | 自动接入路由器分配 IP 并输出日志 | **通过** |
