name718/drone/文档/docs-暂停/3d打印件/机架与电机详细参数.md

# 3D 打印机架与 1306 动力系统匹配规格表 (实测已锁定版)

本文档记录 3D 打印机架底架（`lower_frame-V5.stl`）的实测几何参数，以及已购入的 **1306 3000KV 无刷电机** 与已锁定的 **乾丰 GEMFAN 3052 3寸三叶桨** 的装配指引。

---

## 1. 机架实测几何参数 (lower_frame-V5.stl)

| 测量项 | 实测具体数值 | 说明与装配要点 |
| :--- | :--- | :--- |
| **对角电机轴距 (Wheelbase)** | **`180.0 mm`** | 电机安装中心位于 `(±63.64, ±63.64)`，对角中心距严格为 180mm |
| **机架整体外形** | `153.28 mm × 153.28 mm × 5.40 mm` | 一体式 X 型底架，单连通壳体 |
| **机臂宽度 / 电机底座外径** | 机臂宽 `16.0 mm`，电机座外径 `26.0 mm` | 提供充足的防撞刚度与电机保护 |
| **机架电机孔位** | 原设计为 `12.0 mm × 12.0 mm` (M2 孔) | 适配 12mm 方孔及十字 12mm PCD 电机底座 |
| **电机中心避让孔径** | **`8.4 mm`** | 预留电机底部轴承与 C 扣卡簧下沉旋转空间 |
| **螺旋桨包络** | **3.0 寸 ~ 3.5 寸** | 装 3.0 寸桨（76.2mm）时桨尖间隙约 51mm，气流干扰极小 |
| **中心堆叠安装孔** | **`30.5 mm × 30.5 mm` (M3 孔)** | 用于安装四合一电调与飞控板（坐标 `±15.22, ±15.23`） |
| **电池安装槽** | 4 个 `5.0 mm × 12.0 mm` 扎带槽 | 适配 10mm 宽防滑魔术贴扎带，底置纵向固定 2S 电池 |

---

## 2. 1306 3000KV 电机实物尺寸与乾丰 3052 桨叶装配

### ① 1306 电机实物测绘参数
* **电机外径**：`18.0 mm`（装在 26.0 mm 底座上，四周各有 4.0 mm 塑料防撞缓冲裕量）；
* **本体高度**：`15.2 mm`；
* **螺纹轴径**：**`M5 螺纹 (5.0 mm)`**，光轴台阶直径 `5.5 mm`，轴总长 `9.5 mm`；
* **转速常数**：**`3000KV`**；
  * **2S (7.4V) 动力**：空载转速约 22,200 RPM，动力线性平滑，推重比约 2.8:1，极其适合新手调参首飞；
  * **3S (11.1V) 动力**：空载转速约 33,300 RPM，动力爆发强劲；
* **安装固定**：12mm PCD 十字底座，在 3D 打印塑料臂上用 2mm 手钻对准直接钻 4 个小孔，用 M2×6mm 螺丝从底面锁紧。

### ② 乾丰 GEMFAN 3052 三叶桨参数与安装
* **型号**：`GEMFAN 3052` (尺寸 3.0 × 5.2 inch)；
* **中心孔径**：**标准 M5 通孔**（直接套在 1306 电机 5mm 螺纹轴上）；
* **单片重量**：`1.65 g`（超轻，降低电机转动惯量）；
* **材质特性**：`PC（聚碳酸酯）`，高韧性防炸裂；
* **固定方式**：套入电机轴后，使用 M5 防滑法兰自锁螺母压紧；
* **电机与正反桨旋转方向规则**：
  * **右前电机 (2号)**：逆时针旋转，装 **正桨 (CW)**；
  * **左后电机 (3号)**：逆时针旋转，装 **正桨 (CW)**；
  * **左前电机 (4号)**：顺时针旋转，装 **反桨 (CCW)**；
  * **右后电机 (1号)**：顺时针旋转，装 **反桨 (CCW)**。

---

## 3. 4 块独立单体电调（小蜜蜂 20A）机臂布局与接线规范

```mermaid
flowchart TD
    BAT["2S 动力电池 (XT30)"] --> PDB["电源汇流节点 (并联)"]
    
    PDB -->|7.4V + GND| ESC1["1号机臂电调 (右后)"]
    PDB -->|7.4V + GND| ESC2["2号机臂电调 (右前)"]
    PDB -->|7.4V + GND| ESC3["3号机臂电调 (左后)"]
    PDB -->|7.4V + GND| ESC4["4号机臂电调 (左前)"]
    PDB -->|7.4V + GND| FC["飞控主板 H1 (VBAT/GND)"]

    FC -->|PC6 (TIM3_CH1)| ESC1
    FC -->|PC7 (TIM3_CH2)| ESC2
    FC -->|PC8 (TIM3_CH3)| ESC3
    FC -->|PC9 (TIM3_CH4)| ESC4

    ESC1 -->|3相线| M1["1306 电机 1"]
    ESC2 -->|3相线| M2["1306 电机 2"]
    ESC3 -->|3相线| M3["1306 电机 3"]
    ESC4 -->|3相线| M4["1306 电机 4"]
```

### ① 机械安装
* 每只小蜜蜂电调用透明热缩管绝缘包好，使用 **10mm 宽电工胶带或尼龙扎带** 紧贴固定在 4 根 3D 打印机臂上（机臂宽 16mm，电调宽约 12mm，刚好平贴）；
* 电调直接暴露在螺旋桨的下洗气流中，飞行时风冷散热效果远优于密闭中心机舱。

### ② 电气接线
1. **电机端（3 根焊线）**：电调输出端直接焊接 1306 电机的 3 根引线；若电机旋转方向反了，只需在电调上任意对调其中 2 根焊线即可反转；
2. **信号端（细线）**：每只电调的白色/黄色信号线分别接入飞控主板的 **`PC6 (M1)`、`PC7 (M2)`、`PC8 (M3)`、`PC9 (M4)`**，信号地线并入飞控 GND；
3. **电源端（粗红黑线）**：4 只电调的正负极电源线在机架中心与飞控板的 VBAT 输入并联，统一焊接在 XT30 电池母头上。
