name718/drone/文档/docs-暂停/过程文档/计划.md

# 项目计划入口

项目按以下阶段推进。每个阶段单独记录目标、输出物和验收条件：

1. [x] [需求与器件选型](计划/01-需求与器件选型.md) —— **100% 选型与闭环**
2. [x] [机械尺寸草模](计划/02-机械尺寸草模.md) —— **36x36mm 结构基线确立**
3. [x] [飞控开发板](计划/03-飞控开发板.md) —— **原理图、PCB、DRC 清零、铺铜完成并封板**
4. [ ] [3D 打印与 PCB 打样](计划/04-3D打印与PCB打样.md) —— **（当前阶段）已在嘉立创下单 PCB+SMT，等待到货测试**
5. [ ] [软件实现与板级联调](计划/05-软件实现与板级联调.md)
6. [ ] [测试架与首次试飞](计划/06-测试架与首次试飞.md)
7. [x] [ELRS 遥控控制器硬件落地](计划/07-遥控器控制器硬件落地.md) —— **原理图 ERC 0 错误，一体化裸板手柄 PCB 布局、布线、双面铺铜及 DRC 0 错误全部通过封板**

推荐顺序：先确定器件和约束，建立机械尺寸草模，再设计开发板；机械和 PCB 至少迭代一次后再做最终外观和轻量化。
