name718/drone/文档/docs-暂停/过程文档/04-3D打印与PCB打样.md

# 04 3D 打印与 PCB 打样 (进行中)

## 状态：投板前检查完成 / 尚未下单

---

## 1. PCB 打样与 SMT 下单参数（待确认）

- **下单平台**：嘉立创 PCB + SMT 贴片代工
- **产品尺寸**：`3.6 cm × 3.6 cm`（单片出货，由嘉立创自动加工艺边进行机器贴片）
- **板材规格**：FR-4 双层板，成品板厚 `1.2 mm`，1 盎司铜厚
- **阻焊与外观**：白色阻焊 + 黑色丝印（白底黑字，高对比度视觉效果）
- **表面处理**：**OSP 环保抗氧化有机保焊膜（零加价高平整度）**
- **计划数量**：5 片 PCB + SMT 贴片加工
- **下单前必须确认**：LED2 停产替代料、H1 是否手焊/代贴、实际层叠与阻抗参数、BOM 与坐标文件预览
- **当前禁止项**：未完成嘉立创下单预览和替代料确认前，不提交生产订单

---

## 2. 到货验收与测试标准作业程序 (SOP)

板子顺丰送达后，按以下顺序执行上电前与上电测试：

### Step 1: 裸板外观与短路静态测试（严禁直接接电池！）
1. **显微镜/肉眼外观检查**：
   - 检查 LQFP-64 MCU、LGA-14 陀螺仪、LGA-10 气压计有无连锡、虚焊或偏移；
   - 检查 Type-C 插座外壳与引脚焊点饱满度。
2. **万用表二极管/蜂鸣档静态测阻**：
   - 红表笔接 `GND`，黑表笔分别测 `+5V`、`+3.3V`、`VBAT_RAW` 对地阻值；
   - 确认各电源对地**无短路蜂鸣声**（正常对地阻值通常在数百欧姆至数千欧姆以上）。

### Step 2: 首次 USB 安全上电与供电电压测量
1. 用 Type-C 数据线连接电脑 USB（电脑自带 500mA 自动过流保护）；
2. 观察板载 **LED1 (绿色电源灯)** 是否常亮；
3. 用万用表直流电压档测量：
   - `+5V` 节点电压：应在 `4.75V ~ 5.25V` 之间；
   - `+3.3V` 节点电压：应在 `3.25V ~ 3.35V` 之间（ME6211 输出稳定）。

### Step 3: ST-Link / DAP-Link SWD 烧录与芯片连接测试
1. 将 DAP-Link / ST-Link 连接至飞控板上的 4Pin SWD 调试口（`3.3V, GND, SWCLK, SWDIO`）；
2. 在电脑端使用 STM32CubeProgrammer 打开连接，确认目标芯片为 `STM32G473RCT6`，并识别到 256KB Flash；
3. 进行首次固件擦除与下载测试。

---

## 3. 3D 打印机架与装配

- **机架形式**：100~120mm 轴距 2S 碳纤/3D打印轻量化机架；
- **飞控安装**：裁剪一张 `36mm × 36mm` 的 3M 高弹性减震双面泡棉胶贴在机身几何中心，将飞控板轻压贴紧固定；
- **线束连接**：焊接电调排线、ELRS 接收机硅胶线。
