name718/drone/文档/docs-暂停/过程文档/专业名称.md

# 飞控

# DShot 电机协议

# 姿态控制环

# 温漂

# 无源晶振

# 有源晶振

# ICM-42688-P功能、连接方式、引脚说明

# W25Q128JVSIQ功能、连接方式、引脚说明

# STM32G473RCT6 硬件实现的串口协议

# 2S 锂电池

# 3.3V LDO 芯片

# IP5305T

# SY8120
