name718/drone/文档/docs-暂停/过程文档/05-软件实现与板级联调.md

# 05 软件实现与板级联调

## 目标

逐层验证飞控硬件和软件，确保控制循环可观测、可停止、可复现。

## 主要任务

- 按驱动、传感器校准、滤波、姿态解算、控制环、混控、安全状态机实现；
- 完成 USB/SWD 下载、参数管理和日志；
- 验证 IMU、CRSF、Flash、DShot 和电源监测；
- 所有电机测试先拆桨，逐步进行桌面、单轴和四轴测试。

## 输出物

可运行固件、参数版本、测试日志、已知问题和回归测试记录。
