name718/drone/文档/docs-暂停/过程文档/06-测试架与首次试飞.md

# 06 测试架与首次试飞

## 目标

在可控风险下验证整机控制、结构可靠性和基本飞行能力。

## 主要任务

- 验证电机顺序、方向、X 型混控和输出限幅；
- 验证解锁、失联、倾覆、低电压和急停保护；
- 检查振动、温升、重心、线束固定和螺丝防松；
- 先进行低高度角度模式飞行，再单独接入 ToF 高度环；
- 最后安装摄像头和图传，重新检查供电噪声与 PID。

## 输出物

测试架记录、试飞检查表、飞行日志、问题清单和下一版修改计划。
