name718/drone/firmware_head/artifacts/emotions_preview.png

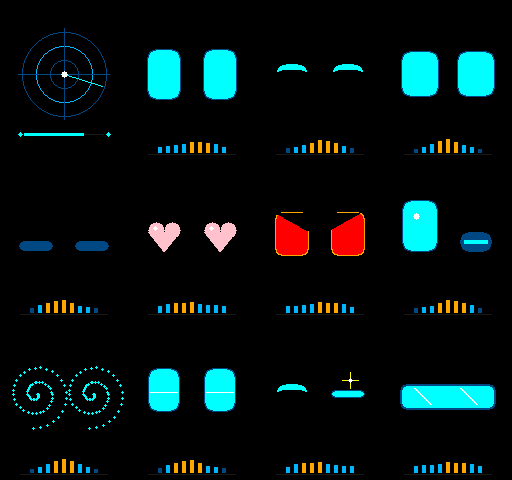
firmware_head/artifacts/emotions_preview.png
