name718/drone/文档/docs-暂停/过程文档/机械成品方案.png

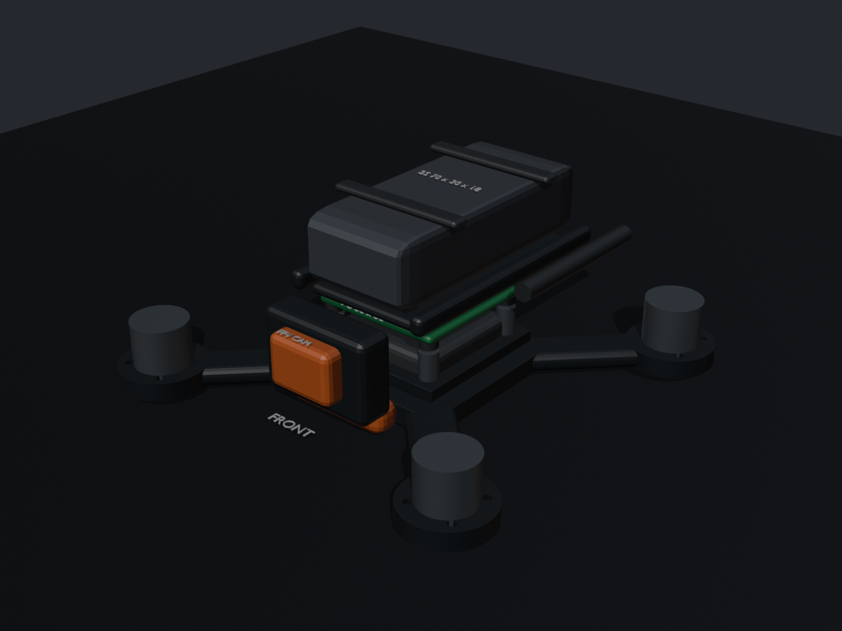
文档/docs-暂停/过程文档/机械成品方案.png
