name718/drone/文档/桌面自平衡机器人2/图片/01-硬件全景.png

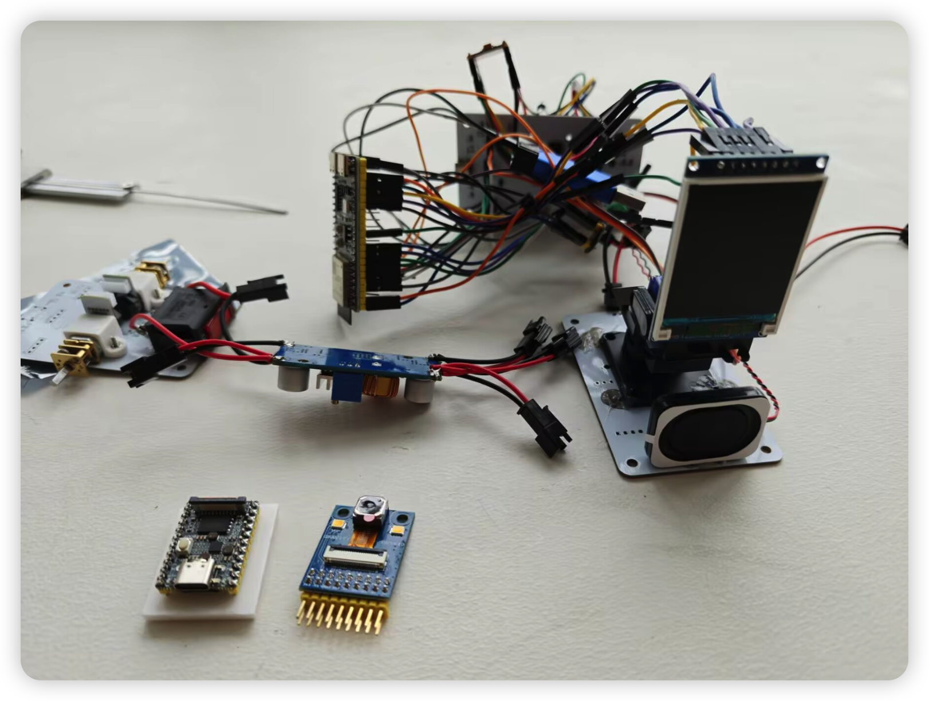
文档/桌面自平衡机器人2/图片/01-硬件全景.png
