name718/drone/文档/桌面自平衡机器人2/图片/03-LM2596降压模块.png

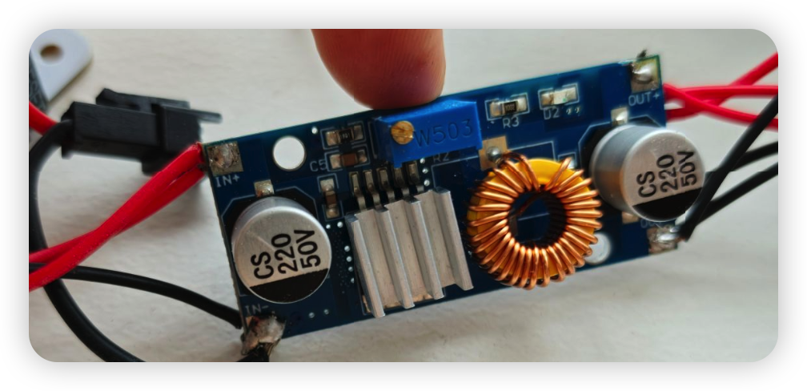
文档/桌面自平衡机器人2/图片/03-LM2596降压模块.png
