name718/drone/文档/桌面自平衡机器人2/图片/04-ESP32-S3开发板.png

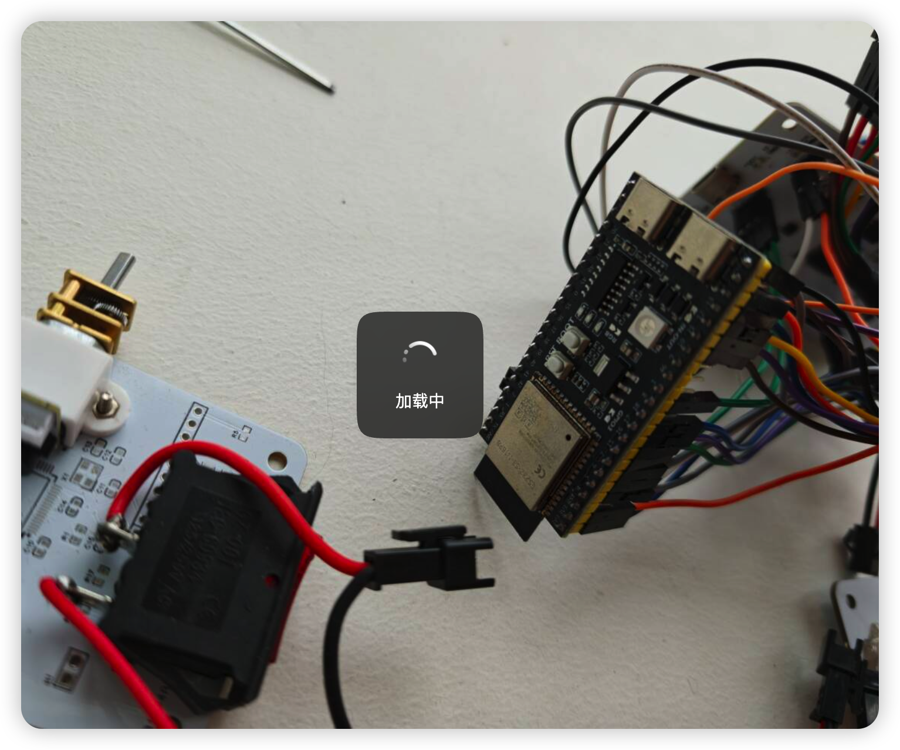
文档/桌面自平衡机器人2/图片/04-ESP32-S3开发板.png
