name718/drone/文档/桌面自平衡机器人2/图片/06-主控板及音频模块.png

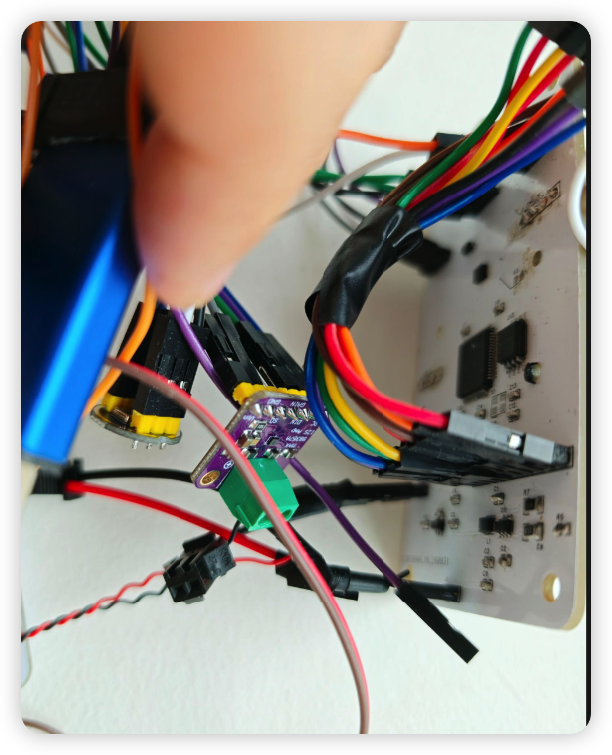
文档/桌面自平衡机器人2/图片/06-主控板及音频模块.png
