name718/drone/文档/桌面自平衡机器人/cad/v1_open_frame_preview.png

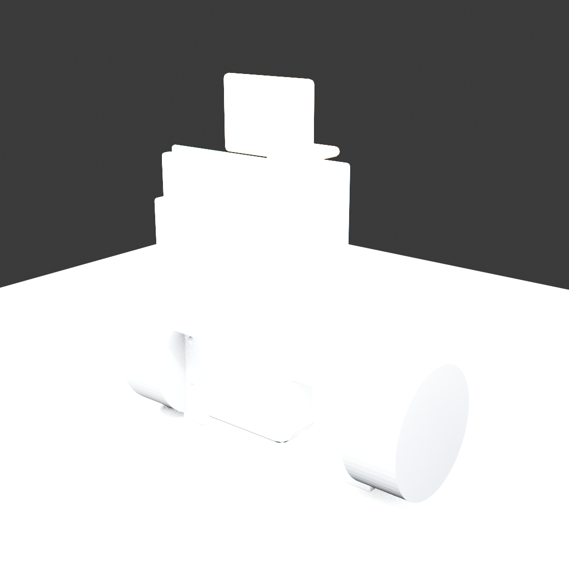
文档/桌面自平衡机器人/cad/v1_open_frame_preview.png
