name718/drone/文档/桌面自平衡机器人/原理图/SCH_Schematic1_1-P1_2026-08-27.png

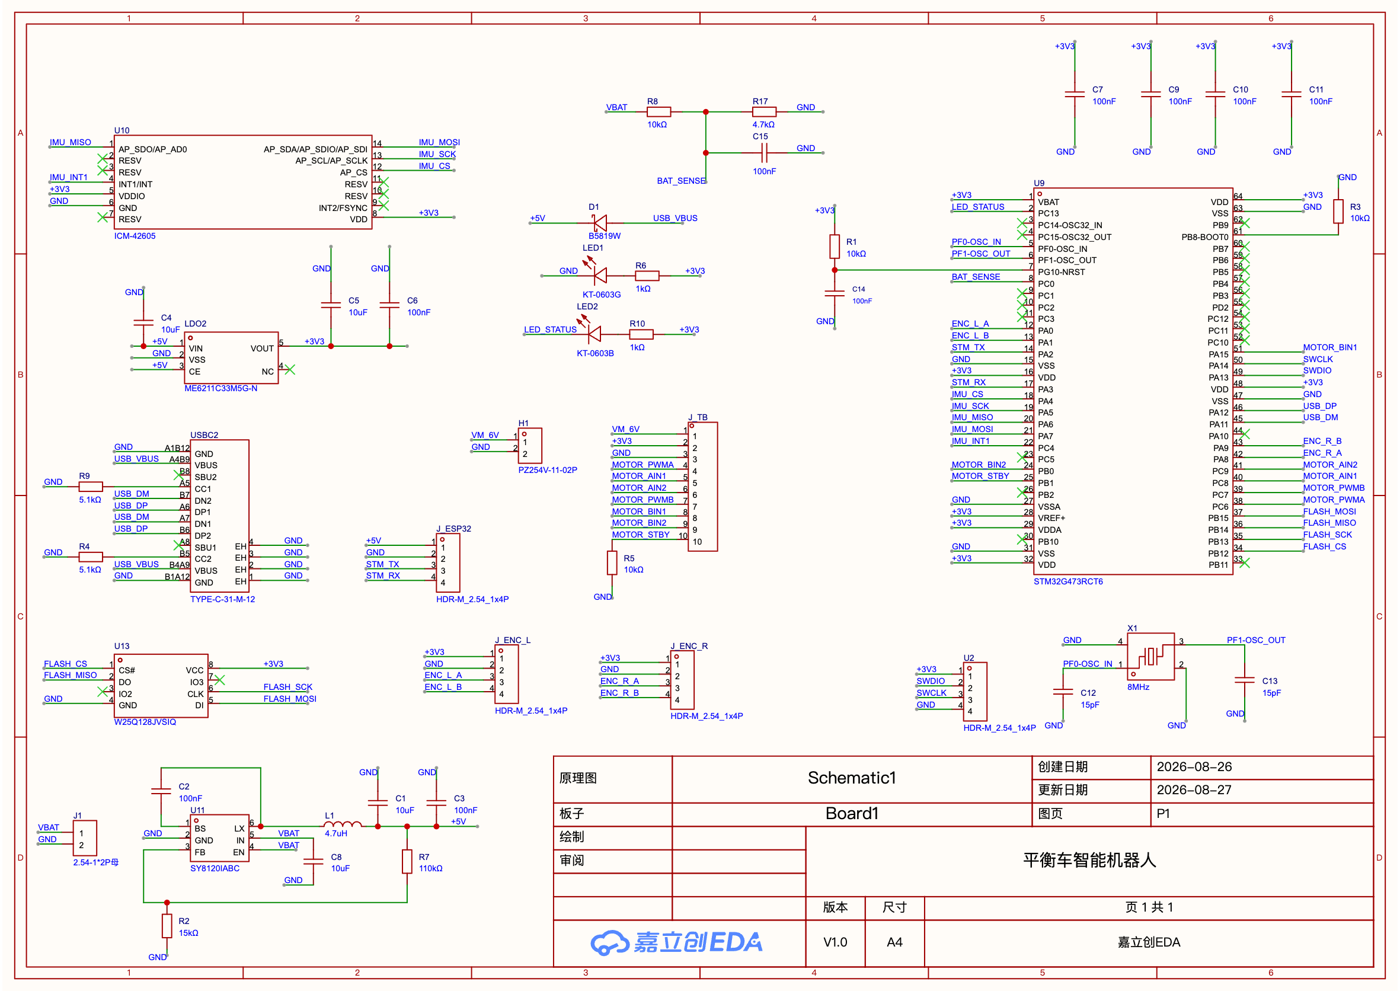
文档/桌面自平衡机器人/原理图/SCH_Schematic1_1-P1_2026-08-27.png
