name718/drone/文档/桌面自平衡机器人/00-当前库存与采购清单.md

# 桌面自平衡智能机器人：当前库存与采购清单

> 更新日期：2026-08-26
>
> 本文按当前沟通记录整理。这里的“已下单”指本次已确认购买，收到实物后仍应核对型号、尺寸、插头和引脚丝印。

## 1. 项目首版范围

首版采用开放式 3D 打印骨架，不制作外壳。

- STM32 主控板负责姿态采样、编码器读取和双轮实时平衡控制。
- ESP32-S3 开发板负责 Wi-Fi、语音交互、OLED 表情/状态显示，以及与 STM32 的 UART 通信。
- 两颗带编码器的 N20 直流减速电机提供动力。
- 电机驱动使用 TB6612FNG 模块。
- 2S 锂电池供电；电机供电经降压模块调至 6.0 V。
- 麦克风和功放均使用 I2S 接口。
- V1 暂不安装雷达或摄像头；新主控 PCB 与开放式骨架必须预留后续扩展条件。

## 2. 已有物料

### 2.1 原无人机项目的可复用板载器件

旧无人机飞控 PCB 不用于机器人，但可复用其已购 BOM 中的器件，设计新的机器人主控 PCB。

| 物料 | 计划用途 | 备注 |
| --- | --- | --- |
| STM32G473RCT6 | 实时平衡控制 MCU | 新机器人主控板核心 |
| ICM-42605 | 六轴 IMU | 姿态角与角速度测量 |
| W25Q128 | 参数与运行日志 Flash | 可选但建议保留 |
| SY8120、ME6211 及外围 | 电源转换 | 新板需按机器人电源需求重新设计 |
| Type-C、ESD、晶振、阻容、SWD 相关器件 | 调试与基础电路 | 按新原理图复用 |
| STM32G030 遥控器板 BOM | 未来实体遥控器 | 首版机器人不作为必需项 |

### 2.2 已有模块与显示器件

| 物料 | 计划用途 | 固定方式建议 |
| --- | --- | --- |
| ESP32-S3 双 USB-C 开发板 | 网络、语音和 UI 协处理器 | 排针卡槽、压板或扎带；不要在无安装孔的 PCB 上硬钻 |
| 1.8 英寸 ST7735 TFT | 预留给未来实体遥控器 | 暂不纳入机器人首版 |
| OLED 屏 | 机器人表情/状态屏 | 接 ESP32-S3 的 I2C |

## 3. 本次已下单物料

### 3.1 动力与电源

| 物料 | 下单规格 | 数量 | 到货验收重点 |
| --- | --- | ---: | --- |
| N20 编码器减速电机套装 | 6 V、300 RPM、带 AB 相霍尔编码器；应含轮子和金属支架 | 2 套 | 每颗应有电机两线和编码器四线/六芯线束；确认轮子为 3 mm D 轴适配 |
| TB6612FNG 双路电机驱动模块 | 小型模块、已焊排针 | 1 | 确认引脚包含 VM、VCC、GND、STBY、AIN1/2、BIN1/2、PWMA/B、AO1/2、BO1/2 |
| 2S 成品锂电池包 | 7.4 V、1800 mAh、带保护板，满电 8.4 V | 1 | 确认是 2S 串联；核对输出插头和正负极 |
| 2S 平衡充电器 | 与电池平衡接口匹配 | 1 | 只使用此类 2S 专用充电器；不可用普通 5 V USB 直接充电 |
| DC-DC 降压模块 | LM2596 类可调降压模块 | 1 | 空载先调至 6.0 V，确认后才接 TB6612 的 VM |
| 直插铝电解电容 | 470 uF / 16 V，高频低阻 | 1 包 | 至少取 1 颗靠近 TB6612 的 VM/GND 安装，注意极性 |
| 两脚带灯过载保护船型开关 | 10 A、2 脚 | 1 | 主电源正极串联；3 脚版本不使用 |
| JST-SM 2P 公母对插线 | 15 cm，10 对 | 1 包 | 适合信号/小电流可插拔连接；动力主线优先使用较粗线材 |

### 3.2 语音交互

| 物料 | 下单规格 | 数量 | 到货验收重点 |
| --- | --- | ---: | --- |
| I2S 数字麦克风 | INMP441 芯片版本、已焊排针 | 1 | 确认 VDD、GND、SCK/BCLK、WS/LRCL、SD、L/R 丝印 |
| I2S 数字功放 | MAX98357A BGA 模块、已焊排针 | 1 | 确认 VIN、GND、BCLK、LRC/WS、DIN 及 SPK+/- 丝印 |
| 腔体扬声器 | 3525，4 Ohm 3 W | 1 | 两根喇叭线只接 MAX98357A 的 SPK+ 和 SPK-，不得接系统 GND |

### 3.3 结构和装配耗材

| 物料 | 下单规格 | 数量 | 用途 |
| --- | --- | ---: | --- |
| 金属螺丝、螺母与垫片 | 圆头 M2/M3 混合套装 | 1 盒 | 3D 打印骨架、支架和模块固定 |
| 尼龙柱 | 黑色单头六角 M3 x 8 + 6，50 个 | 1 包 | 新机器人 PCB 与带安装孔模块的隔离固定 |
| 尼龙扎带 | 2.5 mm x 100 mm | 1 包 | 固定线束和临时固定模块 |
| 背胶魔术贴 | 黑色，2 cm x 15 cm，5 片毛面 + 5 片勾面 | 1 份 | 电池可拆卸定位 |
| 魔术贴绑带 | 10 mm 宽、约 150 mm 长 | 建议 2 条 | 从上方压紧电池；不能只依赖背胶魔术贴  |

## 4. 电源与接线硬约束

### 4.1 电源路径

```text
2S 电池正极
  -> 两脚主电源开关
  -> 分配节点
     -> 降压模块输入 -> 调至 6.0 V -> TB6612 VM -> N20 电机
     -> 机器人主控板电源输入
     -> ESP32-S3 电源输入（须按开发板实际允许输入电压设计）

2S 电池负极
  -> 所有模块 GND 共地
```

- 2S 电池满电为 8.4 V，禁止直接接入标称 6 V 的 N20 电机。
- 降压模块必须在未连接电机时先调至 6.0 V，再接 TB6612 的 `VM`。
- TB6612 的 `VCC` 是逻辑电源，应接 3.3 V；`VM` 才是 6.0 V 电机电源。
- TB6612 的 `STBY` 必须为高电平，驱动才会工作。
- 电解电容正极接 `VM`，负极接 `GND`，并尽量靠近 TB6612。
- 电机换向会产生瞬时大电流。电池、开关、降压模块到 TB6612 的动力线应尽量短，并优先使用 22 AWG 或更粗的硅胶线；细 JST-SM 线不应长期承担高负载动力电流。

### 4.2 音频接口约束

- INMP441 的 `VDD` 使用 3.3 V，不能接 5 V。
- INMP441 与 MAX98357A 可共用 I2S 的 `BCLK` 和 `WS/LRCLK`。
- 麦克风 `SD` 是输出到 ESP32-S3 的输入引脚；MAX98357A 的 `DIN` 由 ESP32-S3 输出。
- INMP441 的 `L/R` 固定接 GND，以单声道左声道模式采样。
- MAX98357A 使用桥接输出，喇叭两线仅接 `SPK+` 和 `SPK-`，任一端都不能接地。

## 5. 尚未下单或等待设计确认的内容

| 内容 | 当前决定 |
| --- | --- |
| 新机器人主控 PCB | 待设计。复用 STM32G473、ICM-42605 等现有 BOM 器件，不复用旧无人机飞控 PCB 布局。 |
| 机器人主控板连接器 | 待根据电机、编码器、ESP32-S3、TB6612 和电池实物接口确定。 |
| 主动力线 | 建议补购 22 AWG 红黑硅胶线；若没有，先不进行长时间高负载运行。 |
| 实体遥控器 | 暂缓。首版优先 ESP32-S3 的 Wi-Fi/BLE 控制和语音交互。 |
| 前向避障 | V1 采用 1 个 VL53L0X I2C ToF 测距模块，作为低速安全避障；不进入实时平衡 PID 控制环。 |
| 摄像头与雷达 | 暂不购买、不安装。后续作为 ESP32-S3 侧的独立扩展模块接入。 |
| 3D 打印骨架 | 到货后按真实尺寸完成 V1 开放式结构设计；不制作外壳，但预留扩展层板和传感器安装位。 |

## 6. V1 扩展预留基线

### 6.1 新机器人主控 PCB

主控板除电机、编码器、IMU 和电源等 V1 必需电路外，至少预留以下未装配或可插拔接口。所有信号均为 3.3 V 逻辑，接口应在丝印中标明针序和电压。

| 预留接口 | 数量 | 推荐针序 / 用途 |
| --- | ---: | --- |
| I2C 扩展口 | 2 组 | `3V3, GND, SDA, SCL`；V1 ToF、未来环境传感器或第二个 ToF |
| UART 扩展口  | 2 组 | `3V3, GND, TX, RX`；一组连接 ESP32-S3，另一组预留摄像头/雷达模块 |
| GPIO 扩展口  | 1 组，至少 6 路 | `3V3, GND, GPIOx...`；按键、LED、红外、限位或其他数字模块 |
| 5 V 电源口 | 1 组 | 供后续高于 3.3 V 的低功耗模块使用；设计时明确持续电流余量 |
| 3.3 V 电源口 | 1 组 | 传感器与低功耗逻辑模块 |
| 调试口 | 1 组 | `3V3, SWDIO, SWCLK, GND`，必须可从骨架外侧接触 |

I2C、UART 与 GPIO 应避免和电机 PWM、编码器定时器、IMU SPI、SWD 复用。摄像头、雷达和语音交互产生的非实时任务不能阻塞 STM32 的姿态与电机控制循环。

### 6.2 ESP32-S3 扩展侧

- ESP32-S3 与 STM32 使用独立 UART；协议只传递高层运动意图和状态，不让 ESP32 直接驱动电机。
- 为后续摄像头预留一个 UART 或 I2C 扩展插座以及 5 V/GND，摄像头默认作为独立模块，不占用 STM32 的关键实时资源。
- I2S 音频和 OLED 的实际 GPIO 在 ESP32-S3 托板上标注，至少保留 4 路未占用 GPIO。
- 开发板使用可拆卸卡槽、压板或排针座固定，不永久胶粘，便于更换为带摄像头的 ESP32-S3 模块。

### 6.3 开放式骨架

- 预留一块标准扩展层板：建议采用 M3 四角安装孔，孔距在完成模块实测后确定。
- 前方预留可调角度的小型传感器座，V1 安装 VL53L0X；将来可换装第二个 ToF、红外或小型摄像头。
- 预留 5 至 10 mm 的走线空间、扎带孔和电源线固定点，避免后续模块线束被轮胎摩擦。
- 电池座保持前后可调，扩展模块增加后可重新调整重心。
- USB、SWD、主电源开关和扩展插座均应从外部可访问。

## 7. 到货后的执行顺序

1. 逐件拍照、测量尺寸、核对标签和引脚丝印，特别是电机线束、TB6612 和电池接口。
2. 不接电机，测试 2S 电池、主开关和降压模块；用万用表将降压输出调为 6.0 V。
3. 完成电机、轮子、电池包、ESP32-S3 和各模块的尺寸占位模型，设计 V1 开放式骨架。
4. 依据最终接口与机械安装位置，绘制新的机器人主控板原理图和 GPIO 资源表。
5. 先单独验证 STM32 的 IMU、编码器和单电机控制，再进行双轮无负载、测试架和地面平衡调试。
6. 语音、OLED 和网络功能在平衡控制安全稳定后接入，避免非实时任务影响控制回路。

## 8. 首次通电安全检查

- 首次使用限流电源或串联保险措施进行测试；不要直接在桌面上进行无保护满功率调试。
- 电机首次测试时让轮子悬空，确认方向、编码器读数和急停逻辑。
- 任何调试或下载固件期间，默认禁用 TB6612 的 `STBY` 或切断电机电源。
- 电池充电时保持看管，使用匹配的 2S 平衡充电器，发现发热、鼓包、异味或线束损坏立即停止使用。
