name718/drone/文档/docs-暂停/购买清单/外设.md

# 整机外设、动力与结构配件精准网购采购清单 (实操锁定与极限省钱版)

本文档为**手持遥控器主板外设**与**四轴飞行器动力配件**的实操采购指南，已精确标注网购平台、有效搜索关键词、核心电气与机械安装参数，并已锁定 **1306 3000KV 电机**、**乾丰 3052 桨叶**、**E34 2.4G 串口模块** 与 **4 个小蜜蜂 20A 独立单体电调方案**。

---

## 1. 遥控器手柄外接配件清单（装在遥控器 PCB 上）

| 序号 | 配件名称 | 核心参数与规格 | 推荐网购平台 | 精准搜索关键词 | 选型注意要点与避坑说明 | 预估单价 | 数量 | 小计 | 采购状态 |
| :---: | :--- | :--- | :---: | :--- | :--- | :---: | :---: | :---: | :---: |
| 1 | **航模操纵摇杆** | • **安装孔距**：`25.4 × 25.4 mm` (4×M2孔)<br>• **接口**：3.3V 4Pin (`VCC, GND, X, Y`)<br>• **模式**：Mode 2 (左油门不回弹 / 右回中) | **拼多多 / 淘宝** | • `FS-i6 摇杆总成`<br>• `T-Lite 摇杆` | • **左手拍「左手油门（不回中）」**，**右手拍「右手方向（自动回中）」**；<br>• 极限省钱选 FS-i6 摇杆 (~12元/只，一对24元)，顺滑长寿选 T-Lite 塑料霍尔版 (~28元/只)。 | ~12~28 元 | 2 个 | ~24~56 元 | 待买 |
| 2 | **彩色显示屏** | • **尺寸**：1.8 寸 TFT 彩屏<br>• **驱动芯片**：ST7735<br>• **接口**：8Pin 2.54mm 单排针 SPI<br>• **逻辑电平**：3.3V | **拼多多** | • `1.8寸 TFT 8P ST7735`<br>• `ST7735 1.8寸 液晶模块` | • **必须选 8Pin 直插排针款**（非 FPC 软排线款）；<br>• 引脚定义一般为：`VCC, GND, SCL, SDA, CS, DC, RES, BL`，直插 J5。 | ~9.0 元 | 1 个 | ~9.0 元 | 待买 |
| 3 | **2.4G 发射模块** *(已锁定)* | • **型号**：**亿佰特 E34-2G4H20D (带天线款)**<br>• **频段**：2.4GHz 自动跳频<br>• **协议**：标准 UART 串口透传 (4Pin)<br>• **供电**：5V 供电 | **闲鱼** | • `E34-2G4H20D`<br>• `易佰特无线模块 E34` | • **闲鱼 45 元包邮两块（含发射+接收）**；<br>• 4 根线直插 PCB 顶部的 J6 (`5V, GND, TX, RX`)，免写复杂无线底层；<br>• 配 3.1cm 自制天线或外接 2.4G 胶棒天线。 | ~22.5 元 | 1 个 | ~22.5 元 | 已锁定 |
| 4 | **三段拨动开关** | • **类型**：SPDT (ON-OFF-ON) 3档<br>• **引脚**：3 脚微型摇头开关 | **拼多多 / 淘宝** | • `微型三段拨动开关 3脚` | • 焊接在 J8、J9 位置，切换飞行模式。 | ~2.5 元 | 2 个 | ~5.0 元 | 待买 |
| 5 | **两段拨动开关** | • **类型**：SPST / SPDT (ON-OFF) 2档<br>• **引脚**：2 脚或 3 脚微型开关 | **拼多多 / 淘宝** | • `微型两档拨动开关` | • 焊接在 J10、J11 位置，用作解锁/急停开关。 | ~2.0 元 | 2 个 | ~4.0 元 | 待买 |
| 6 | **遥控器电池** | • **规格**：1S 3.7V 聚合物锂电 (带保护板)<br>• **容量**：800mAh ~ 1200mAh | **拼多多** | • `3.7V 聚合物锂电池 带保护板` | • **必须带保护板**，尺寸适配手柄背面（接 J2）。 | ~8.0 元 | 1 块 | ~8.0 元 | 待买 |
| 7 | **螺丝与铜柱包** | • M2×6mm 螺丝 (固定摇杆)<br>• M3×8mm 铜柱螺母 (四角桌面脚垫) | **拼多多** | • `M2 M3 螺丝铜柱套装` | • 锁紧 2 个摇杆总成及底角支撑。 | ~8.0 元 | 1 套 | ~8.0 元 | 待买 |
| **小计** | | | | | **遥控器手柄外设配件全套** | | | **~80 ~ 112 元** | |

---

## 2. 四轴无人机机身动力与配件清单（装在飞机上）

| 序号 | 配件名称 | 核心参数与规格 | 推荐网购平台 | 精准搜索关键词 | 选型注意要点与避坑说明 | 预估单价 | 数量 | 小计 | 采购状态 |
| :---: | :--- | :--- | :---: | :--- | :--- | :---: | :---: | :---: | :---: |
| 1 | **无刷电机** *(已买)* | • **型号**：**1306 无刷电机**<br>• **KV 值**：**3000KV** (大扭矩，支持 2S~3S)<br>• **尺寸**：直径 18mm，高 15.2mm<br>• **轴径**：**M5 螺纹轴 (5mm)**，轴长 9.5mm | **淘宝 / 拼多多** | • `1306 无刷电机 3000KV` | • 扭矩充沛，2S (7.4V) 下平稳柔和，推重比可达 2.8:1；<br>• 12mm PCD 孔位直接在 3D 打印塑料机臂上用 2mm 钻头扎孔锁紧。 | ~12.5 元 | 4 颗 | ~50.0 元 | **已买** |
| 2 | **螺旋桨** *(已锁定)* | • **型号**：**乾丰 GEMFAN 3052 3寸三叶桨**<br>• **材质**：PC（耐撞柔韧聚碳酸酯，单片重 1.65g）<br>• **孔径**：**标准 M5 通孔 (适配 1306 螺纹轴)** | **淘宝 / 闲鱼** | • `Gemfan 3052 3寸 穿越机螺旋桨` | • **7.99 元整包（2 对 4 支装：2 正 2 反）**；<br>• 专为 1306-1806 电机设计，抓风力强、大推力。 | ~7.99 元/包 | 1~2 包 | ~7.99 元 | 已锁定 |
| 3 | **无刷单体电调 (4只方案)** *(已锁定)* | • **型号**：**小蜜蜂 LittleBee-Spring 20A 单体电调**<br>• **固件**：**BLHeli_S**<br>• **协议**：支持 **DShot600 / DShot300**<br>• **支持电压**：2S (7.4V) ~ 4S (14.8V) | **拼多多 / 淘宝** | • `BLHeli-S 小蜜蜂 20A 电调`<br>• `LittleBee 20A Dshot` | • **极致省钱且独立安全**：单只仅 9~10 元，4 块总共才 36~40 元；<br>• 绑在 4 根机臂上散热极佳，坏 1 个换 1 个只要 9 块钱；<br>• 4 根信号线分别接飞控的 M1, M2, M3, M4。 | ~9.0 元 | **4 块** | **~36.0 元** | 已锁定 |
| 4 | **2.4G 接收模块** *(已锁定)* | • **型号**：**亿佰特 E34-2G4H20D (带天线款)**<br>• **通信协议**：标准 UART 串口透传<br>• **供电**：5V 供电 | **闲鱼** | • `E34-2G4H20D` (与发射端同一套) | • **即插即用**：4 根线（`5V, GND, TX, RX`）直连飞控接收机插座；<br>• 与手柄发射端自动对通，视距通信稳定不丢包。 | ~22.5 元 | 1 个 | ~22.5 元 | 已锁定 |
| 5 | **动力锂电池** | • **规格**：2S 7.4V 锂聚合物动力电池 (LiPo)<br>• **容量**：450mAh ~ 650mAh (60C~80C)<br>• **接口**：**XT30 接头** | **拼多多** | • `2S 450mah 7.4V XT30`<br>• `格氏 2S 450mah` | • **必须带 XT30 接头**，先买 1 块单电起步调参即可。 | ~18.0 元 | 1 块 | ~18.0 元 | 待买 |
| 6 | **平衡充电器** | • **型号**：**B3 2S/3S 简易锂电平衡充** | **拼多多** | • `B3 锂电池平衡充` | • 必须通过动力电池的 3Pin 白色平衡头充电，防止电芯压差过大。 | ~12.0 元 | 1 台 | ~12.0 元 | 待买 |
| 7 | **辅料与减震胶** | • 3M 双面减震泡棉 + 10*150mm 电池扎带 + 热缩管 | **拼多多** | • `3M 双面泡棉胶` / `电池扎带` | • 飞控贴装隔振与机臂电调捆扎固定。 | ~5.0 元 | 1 套 | ~5.0 元 | 待买 |
| **小计** | | | | | **四轴整机动力与配件全套** | | | **~151.5 元** | |

---

## 3. 调试与装配耗材

| 序号 | 工具名称 | 规格参数 | 推荐网购平台 | 精准搜索关键词 | 预估单价 |
| :---: | :--- | :--- | :---: | :--- | :--- | :---: |
| 1 | **SWD 烧录调试器** | DAP-Link 或 ST-Link V2 (带杜邦线) | **拼多多 / 淘宝** | `DAP-Link 烧录器` | ~12.0 元 (若手头已有可省) |
| 2 | **耐高温超软硅胶线** | 28AWG 特氟龙硅胶软线 | **拼多多** | `28AWG 硅胶线 航模` | ~5.0 元 |

---

## 剩余待购总预算最终结算（扣除已买电机）

| 模块类别 | 选型配置方案 | 预算小计 |
| :--- | :--- | :---: |
| **1. 遥控器手柄外设** | FS-i6 摇杆一对 + ST7735 彩屏 + E34 2.4G 发射端 + 开关电池 | **~80 元** |
| **2. 四轴无人机机身动力** | 4颗 1306 电机(已买) + 乾丰3052桨(7.99元) + **4块小蜜蜂20A电调(36元)** + E34接收端 + 2S电池平衡充 | **~101.5 元** |
| **剩余真正待支付总花费** | **全部配件购齐并起飞** | **约 181.5 元（完美控制在 200 元预算内！）** |
