name718/drone/文档/docs-暂停/购买清单/贴片.md

# 贴片与板载电子元器件合并采购清单 (带预估价格&防漏版)

> **采购核心原则**：
> 1. **贴片阻容**：由于 0603 元件极其微小（1.6×0.8mm），镊子一弹极易飞丢，淘宝通常 1~2 元/包（20~50 颗），**强烈建议直接按整包拍**；
> 2. **核心芯片与易损件**：手工烙铁/风枪焊接存在虚焊、连锡或静电击穿风险，**建议关键芯片多买 1 颗作为备用**；
> 3. **贴片总预算预估**：**约 150 ~ 190 元**（包含飞控与遥控器双份核心芯片与整包阻容）。

---

## 1. 易损件风险评估与建议采购量表

| 器件名称 | 封装 | 理论净用量 | **建议采购量** | 预估单价 | 预估小计 | 易损原因与焊接防坑提示 |
| :--- | :--- | :---: | :---: | :---: | :---: | :--- |
| **ICM-42688-P / 42605** (陀螺仪) | LGA-14 | 1 颗 | **2 颗** | ~18.0 元 | ~36.0 元 | **最高危**：底部焊盘无外露引脚，风枪温度过高 (>260℃) 会损坏内部 MEMS 结构。 |
| **BMP388** (气压计) | LGA-10 | 1 颗 | **2 颗** | ~12.0 元 | ~24.0 元 | **极娇气**：顶部有微小感压通气孔，**严禁洗板水/助焊剂流入孔内**。 |
| **STM32G473RCT6** (飞控 MCU) | LQFP-64 | 1 颗 | **2 颗** | ~20.0 元 | ~40.0 元 | 0.5mm 密引脚，初学者拖焊若温度过高易损坏，备 1 颗容错率高。 |
| **STM32G030C8T6** (遥控 MCU) | LQFP-48 | 1 颗 | **2 颗** | ~5.5 元 | ~11.0 元 | 0.5mm 密引脚，单价低，备 1 颗防连锡击穿。 |
| **Type-C 16Pin 插座** | 贴片+插板 | 2 个 | **3~4 个** | ~0.6 元 | ~2.4 元 | 焊外壳固定脚若烙铁停留过久，内部塑料舌片易受热融化。 |
| **ME6211C33M5G-N** (3.3V LDO) | SOT-23-5 | 2 颗 | **3~4 颗** | ~0.4 元 | ~1.6 元 | 单价极低，易因调试短路瞬间击穿。 |
| **IP5306** (电源芯片) | ESOP-8 | 1 颗 | **2 颗** | ~2.5 元 | ~5.0 元 | 底部带散热地焊盘，焊接需保证底面接地良好。 |
| **SY8120IABC** (5V Buck 降压) | SOT-23-6 | 1 颗 | **2 颗** | ~1.2 元 | ~2.4 元 | 电源调试时若输入反接或短路易烧毁。 |
| **0603 贴片发光 LED** | 0603 | 3 颗 | **各 1 包(10~20颗)**| ~2.0 元/包 | ~4.0 元 | LED 不耐高温，烙铁接触焊盘超过 3 秒易烧坏发光芯片。 |
| **TS-1088 贴片按键** | 3×4mm | 3 个 | **5~6 个** | ~0.3 元 | ~1.8 元 | 内部弹片塑料封装，手焊过热手感易变软失灵。 |

---

## 2. 芯片与专用 IC（两板汇总）

| 序号 | 器件名称 / 规格型号 | 封装形式 | 实际用量 | **建议购买量** | 预估单价 | 预估小计 | 淘宝搜索关键词 |
| :---: | :--- | :--- | :---: | :---: | :---: | :---: | :--- |
| 1 | **STM32G473RCT6** | LQFP-64 | 1 颗 | **2 颗** | 20.0 元 | 40.0 元 | `STM32G473RCT6 芯片` |
| 2 | **STM32G030C8T6** | LQFP-48 | 1 颗 | **2 颗** | 5.5 元 | 11.0 元 | `STM32G030C8T6 芯片` |
| 3 | **ME6211C33M5G-N** (3.3V LDO)| SOT-23-5 | 2 颗 | **4 颗** | 0.4 元 | 1.6 元 | `ME6211C33 SOT-23-5` |
| 4 | **S8050 (J3Y) NPN 三极管** | SOT-23 | 2 颗 | **5 颗** | 0.1 元 | 0.5 元 | `S8050 J3Y SOT-23` |
| 5 | **IP5306** (带按键控制版) | ESOP-8 | 1 颗 | **2 颗** | 2.5 元 | 5.0 元 | `IP5306 芯片 ESOP8` |
| 6 | **SY8120IABC** (2A Buck 降压) | SOT-23-6 | 1 颗 | **2 颗** | 1.2 元 | 2.4 元 | `SY8120IABC 芯片` |
| 7 | **ICM-42688-P** 或 **ICM-42605** | LGA-14 | 1 颗 | **2 颗** | 18.0 元 | 36.0 元 | `ICM-42688-P 芯片` / `ICM-42605` |
| 8 | **BMP388** | LGA-10 | 1 颗 | **2 颗** | 12.0 元 | 24.0 元 | `BMP388 贴片气压计` |
| 9 | **W25Q128JVSIQ** (16MB NOR) | SOIC-8 (208mil)| 1 颗 | **2 颗** | 2.8 元 | 5.6 元 | `W25Q128 贴片 SPI Flash` |
| 10 | **USBLC6-2SC6** (ESD 保护) | SOT-23-6 | 1 颗 | **2 颗** | 0.8 元 | 1.6 元 | `USBLC6-2SC6 贴片` |
| **小计**| | | | | | **~127.7 元** | |

---

## 3. 贴片电阻清单（0603 封装，整包采购）

| 阻值参数 | 精度 / 封装 | 实际总用量 | **建议淘宝采购量** | 预估单价 | 预估小计 | 用途与分布 |
| :--- | :--- | :---: | :---: | :---: | :---: | :--- |
| **10kΩ** | 1% / 0603 | 4 颗 | **1 包 (50 颗)** | 1.5 元/包 | 1.5 元 | 飞控/遥控电池分压与上拉 |
| **1kΩ** | 1% / 0603 | 4 颗 | **1 包 (50 颗)** | 1.5 元/包 | 1.5 元 | 蜂鸣器基极限流、LED 限流 |
| **5.1kΩ** | 1% / 0603 | 4 颗 | **1 包 (50 颗)** | 1.5 元/包 | 1.5 元 | 飞控与遥控 Type-C CC 下拉识别 |
| **47Ω** | 1% / 0603 | 4 颗 | **1 包 (50 颗)** | 1.5 元/包 | 1.5 元 | 飞控 4 路 DShot 电机输出阻抗匹配 |
| **100kΩ** | 1% / 0603 | 1 颗 | **1 包 (50 颗)** | 1.5 元/包 | 1.5 元 | 飞控 SY8120 5V 反馈上偏置电阻 |
| **20kΩ** | 1% / 0603 | 1 颗 | **1 包 (50 颗)** | 1.5 元/包 | 1.5 元 | 飞控 SY8120 5V 反馈下偏置电阻 |
| **小计** | | | | | **~9.0 元** | *(共 6 包，每包 50 颗)* |

---

## 4. 贴片电容、电感与晶振清单

| 器件规格 | 封装 / 材质 | 实际总用量 | **建议淘宝采购量** | 预估单价 | 预估小计 | 用途与说明 |
| :--- | :--- | :---: | :---: | :---: | :---: | :--- |
| **100nF (0.1uF/104)**| 0603 (16V~50V) | 12 颗 | **1 包 (50 颗)** | 2.0 元/包 | 2.0 元 | MCU 供电去耦、传感器与 ADC 滤波 |
| **10uF (106)** | 0603 (10V~25V) | 8 颗 | **1 包 (50 颗)** | 2.5 元/包 | 2.5 元 | 5V Buck / LDO 输入输出电源滤波 |
| **15pF** | 0603 (C0G/NPO) | 2 颗 | **1 包 (20 颗)** | 1.5 元/包 | 1.5 元 | 飞控 8MHz 晶振匹配电容 |
| **22nF (223)** | 0603 (16V~50V) | 1 颗 | **1 包 (20 颗)** | 1.5 元/包 | 1.5 元 | 飞控 SY8120 BST 升压自举电容 |
| **100uF 大电容** | 1206 贴片 / 直插 | 1 颗 | **3 颗** | 1.2 元 | 3.6 元 | 遥控器 ELRS 发射机 5V 稳压大电容 |
| **2.2uH 功率电感** | 1210 / 3225 贴片 | 1 颗 | **2 颗** | 1.5 元 | 3.0 元 | 遥控器 IP5306 升压储能电感 |
| **4.7uH 一体成型电感**| 0420 / 4×4mm 贴片| 1 颗 | **2 颗** | 1.8 元 | 3.6 元 | 飞控 SY8120 降压滤波功率电感 |
| **8MHz 贴片晶振** | 3225 无源 (12pF) | 1 颗 | **2 颗** | 1.0 元 | 2.0 元 | 飞控主系统外部高速晶振 |
| **小计** | | | | | **~19.7 元** | |

---

## 5. 接口、指示灯、按键与蜂鸣器

| 器件名称 / 规格 | 封装形式 | 实际总用量 | **建议购买量** | 预估单价 | 预估小计 | 淘宝搜索关键词 |
| :--- | :--- | :---: | :---: | :---: | :---: | :--- |
| **TYPE-C-31-M-12** (16P) | 16Pin 贴片四脚插板 | 2 个 | **4 个** | 0.6 元 | 2.4 元 | `Type-C 16P 四脚插板 母座` |
| **0603 绿色 LED** | 0603 贴片 | 2 颗 | **1 包 (20颗)** | 2.0 元/包 | 2.0 元 | `0603 贴片 LED 绿灯` |
| **0603 蓝色 LED** | 0603 贴片 | 1 颗 | **1 包 (20颗)** | 2.0 元/包 | 2.0 元 | `0603 贴片 LED 蓝灯` |
| **TS-1088 按键 (3×4mm)** | 3×4 贴片 | 3 个 | **6 个** | 0.3 元 | 1.8 元 | `贴片轻触按键 3*4*2` |
| **无源蜂鸣器 (9×5.5mm)** | 3V~5V 直插 (4mm距) | 2 个 | **3 个** | 1.0 元 | 3.0 元 | `9*5.5 无源蜂鸣器 3V` |
| **SH1.0 8Pin 卧贴插座** | 1.0mm 间距贴片 | 1 个 | **2 个** | 1.0 元 | 2.0 元 | `SH1.0 8P 卧贴插座` |
| **2.54mm 单排针 / 排母套件**| 2.54mm 间距直插 | 1~2 条 | **2 条 (40Pin)** | 2.0 元/条 | 4.0 元 | `2.54 单排针 排母 40P` |
| **小计** | | | | | **~17.2 元** | |

---

## 6. 手工焊接必备耗材与辅助工具

| 序号 | 耗材 / 工具名称 | 规格参数 | 数量 | 预估价格 | 作用说明 |
| :---: | :--- | :--- | :---: | :---: | :--- |
| 1 | **有铅免洗焊锡丝** | `63/37 焊锡丝 0.8mm (50g或小卷)` | 1 卷 | ~12.0 元 | 熔点低、流动性好、焊点圆润光亮 |
| 2 | **针筒助焊膏** | `RMA-223` 或 `NC-559 (10cc带推杆)` | 1 支 | ~8.0 元 | 拖焊 QFP 芯片核心防连锡利器 |
| 3 | **编织吸锡带** | `2.0mm 宽度 (1.5米)` | 1 卷 | ~5.0 元 | 极速清理引脚桥连连锡 |
| 4 | **高精密弯头镊子** | `ESD-15 防静电不锈钢镊子` | 1 把 | ~4.0 元 | 夹取 0603 阻容与轻触按键 |
| 5 | **洗板水 / 酒精** | `99% 无水乙醇 + 小毛刷` | 1 瓶 | ~6.0 元 | 焊完清洗松香残留，保持板面洁净 |
| **小计** | | | | **~35.0 元** | |

---

## 贴片部分总预算汇总：
* **芯片与专用 IC**：约 128 元
* **阻容电感晶振**：约 29 元
* **接口接插件与按键**：约 17 元
* **焊接耗材**：约 35 元
* **贴片元器件总预算：约 170 ~ 210 元**（含全部备用芯片与整包阻容）
包 (20 颗)** | 飞控 8MHz 晶振匹配电容 |
| **22nF (223)** | 0603 (16V~50V) | 1 颗 | 0 颗 | 1 颗 | **1 包 (20 颗)** | 飞控 SY8120 BST 升压自举电容 |
| **100uF 大电容** | 1206 贴片 / 直插 | 0 颗 | 1 颗 | 1 颗 | **3 颗** | 遥控器 ELRS 发射机 5V 稳压大电容 |
| **2.2uH 功率电感** | 1210 / 3225 贴片 | 0 颗 | 1 颗 | 1 颗 | **2 颗** | 遥控器 IP5306 升压储能电感 |
| **4.7uH 一体成型电感**| 0420 / 4×4mm 贴片| 1 颗 | 0 颗 | 1 颗 | **2 颗** | 飞控 SY8120 降压滤波功率电感 |
| **8MHz 贴片晶振** | 3225 无源 (12pF) | 1 颗 | 0 颗 | 1 颗 | **2 颗** | 飞控主系统外部高速晶振 |

---

## 5. 接口、指示灯、按键与蜂鸣器

| 器件名称 / 规格 | 封装形式 | 飞控用量 | 遥控用量 | **实际总用量** | **建议购买量** | 淘宝搜索关键词 |
| :--- | :--- | :---: | :---: | :---: | :---: | :--- |
| **TYPE-C-31-M-12** (16P) | 16Pin 贴片四脚插板 | 1 | 1 | 2 个 | **3~4 个** | `Type-C 16P 四脚插板 母座` |
| **0603 绿色 LED** | 0603 贴片 | 1 | 1 | 2 颗 | **1 包 (10~20颗)**| `0603 贴片 LED 绿灯` |
| **0603 蓝色 LED** | 0603 贴片 | 1 | 0 | 1 颗 | **1 包 (10~20颗)**| `0603 贴片 LED 蓝灯` |
| **TS-1088 按键 (3×4mm)** | 3×4 贴片 | 0 | 3 | 3 个 | **5~6 个** | `贴片轻触按键 3*4*2` |
| **无源蜂鸣器 (9×5.5mm)** | 3V~5V 直插 (4mm距) | 1 | 1 | 2 个 | **2~3 个** | `9*5.5 无源蜂鸣器 3V` |
| **SH1.0 8Pin 卧贴插座** | 1.0mm 间距贴片 | 1 | 0 | 1 个 | **2 个** | `SH1.0 8P 卧贴插座` |
| **2.54mm 单排针 / 排母套件**| 2.54mm 间距直插 | 若干 | 若干 | 1~2 条 | **2 条 (40Pin)** | `2.54 单排针 排母 40P` |

---

## 6. 手工焊接避坑 SOP（按此顺序焊接成功率 100%）

1. **第一步：先焊电源部分（不要焊 MCU 和传感器！）**
   * 遥控器：焊 Type-C、IP5306、L1、C1、C6、ME6211、LDO 电容；
   * 飞控板：焊 SY8120、4.7uH、ME6211、电源阻容；
   * **万用表通电测量**：测 `+5V` 节点是否为 5.0V，`+3.3V` 节点是否为 3.3V。**只有电压完全正确才能焊后面的主控！**
2. **第二步：焊主控 MCU (STM32) 与晶振**
   * 抹上助焊膏，先固定对角两根引脚，然后加锡拖焊，最后用吸锡带吸除桥连连锡；
   * 焊接 SWD 4Pin 调试口，插上 ST-Link/DAP-Link，在电脑上确认能成功识别到芯片并烧录。
3. **第三步：焊传感器与外设 (最后焊精密器件)**
   * 用热风枪 (240~250℃) 吹焊 ICM-42688 和 BMP388（注意气压计不能让洗板水泡入小孔）；
   * 焊接排针、按键、蜂鸣器与 LED。
