name718/drone/cad/drone_mockup_components.step

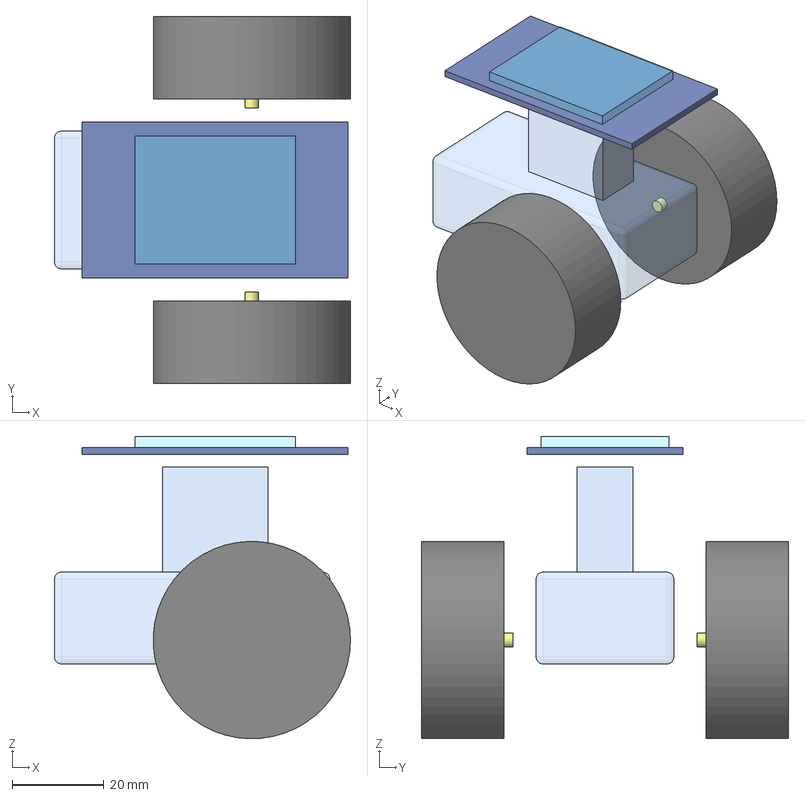
[picture p12: CAD file, 2026-10-11]
cad/drone_mockup_components.step
64.5 x 80.0 x 65.9 mm
n20_motor_left
n20_shaft_left
wheel_left
n20_motor_right
n20_shaft_right
wheel_right
battery_3s
lcd_pcb
lcd_glass
sg90_pan
