name718/drone/文档/docs-暂停/3d打印件/lower_frame-V5.stl

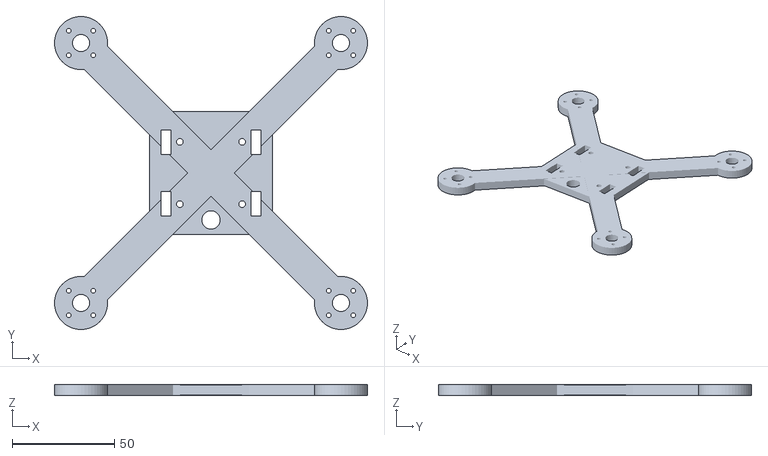
[picture p13: CAD file, 2026-08-16]
文档/docs-暂停/3d打印件/lower_frame-V5.stl
153.3 x 153.3 x 5.40
