name718/drone/文档/桌面自平衡机器人/cad/v1_open_frame_parts.stl

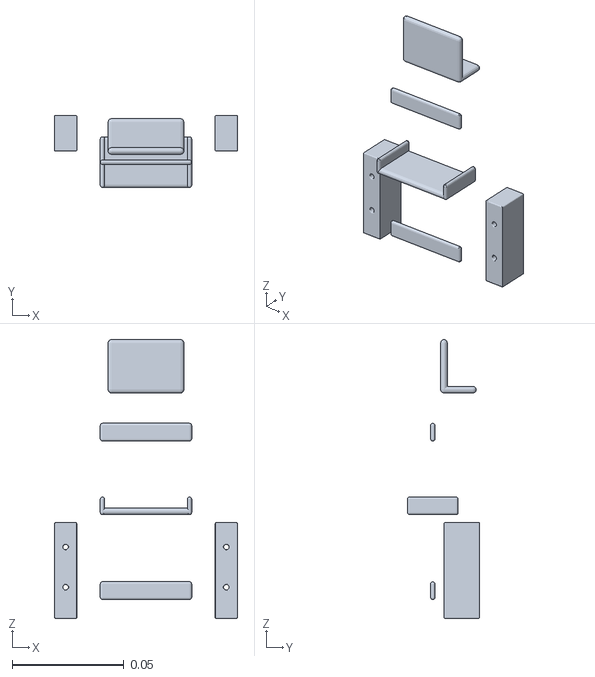
[picture p14: CAD file, 2026-08-28]
文档/桌面自平衡机器人/cad/v1_open_frame_parts.stl
0.082 x 0.0324 x 0.125
