name718/drone/cad/drone_chassis_core.step

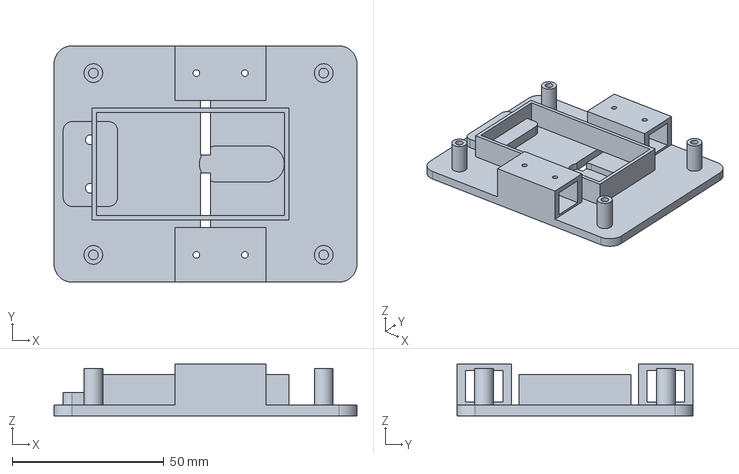
[picture p15: CAD file, 2026-10-11]
cad/drone_chassis_core.step
100.0 x 78.0 x 17.0 mm
