name718/drone/(list of files, cad)

Other CAD files:
cad/drone_chassis_core.stl
文档/docs-暂停/计划/机械尺寸草模.blend
文档/docs-暂停/计划/机械成品方案-V2.blend
文档/docs-暂停/计划/机械成品方案-V4.blend
文档/docs-暂停/计划/机械成品方案-V5.blend
文档/docs-暂停/计划/机械成品方案.blend
文档/桌面自平衡机器人/cad/v1_open_frame.blend
