name718/drone/文档/桌面自平衡机器人/原理图/SCH_Schematic1_2026-08-27.pdf

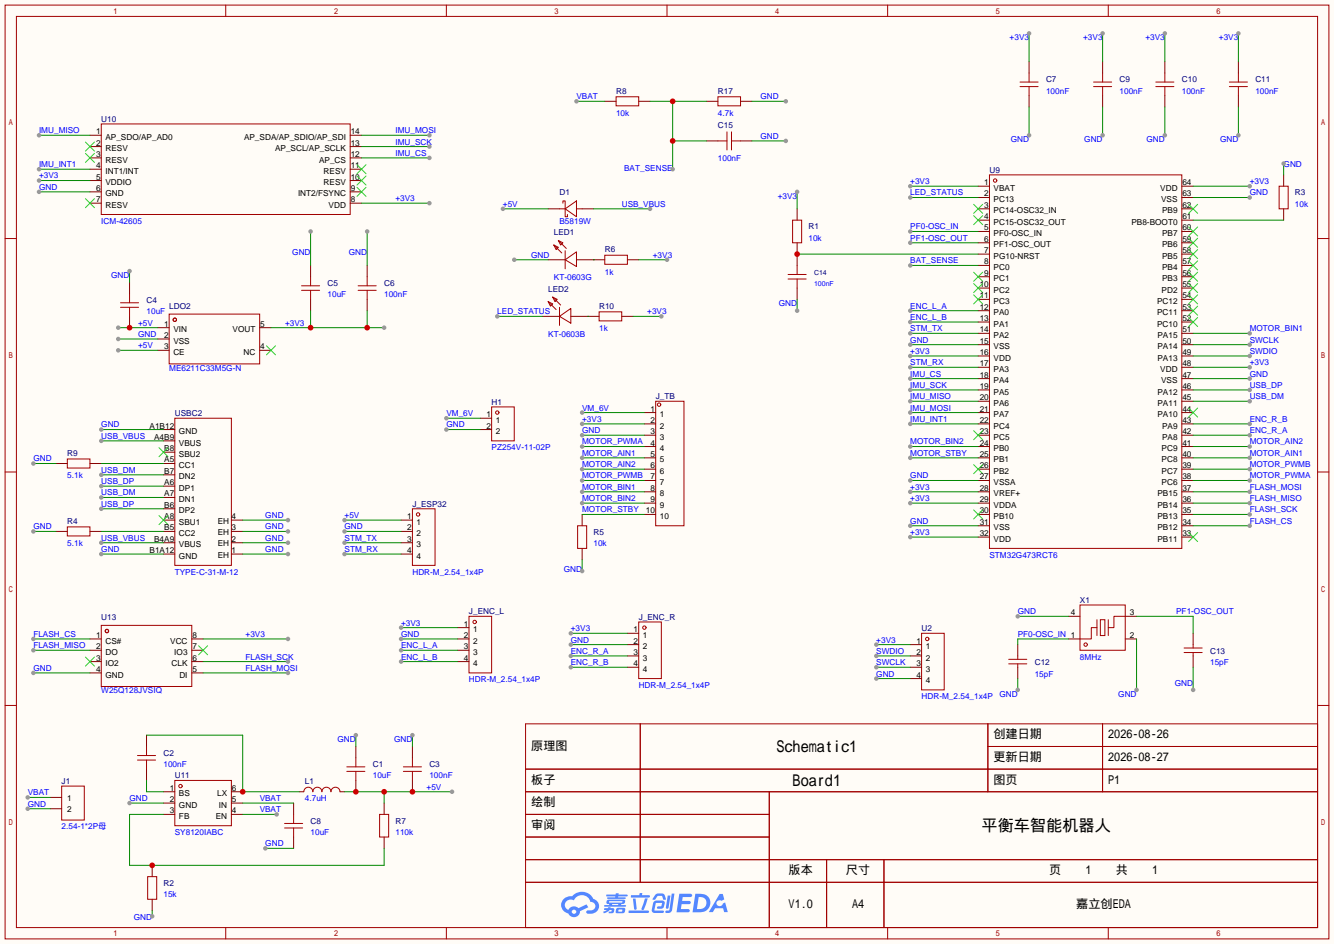
[picture p16: page 1]

原理图 | Schematic1 | 创建日期 | 2026-08-26

更新日期 | 2026-08-27

板子 | Board1 | 图页 | P1

绘制 | | 平衡车智能机器人
审阅

V1.0 | A4 | 嘉立创EDA
