name718/drone/文档/docs-暂停/原理图/SCH_Schematic1_2026-08-21.pdf

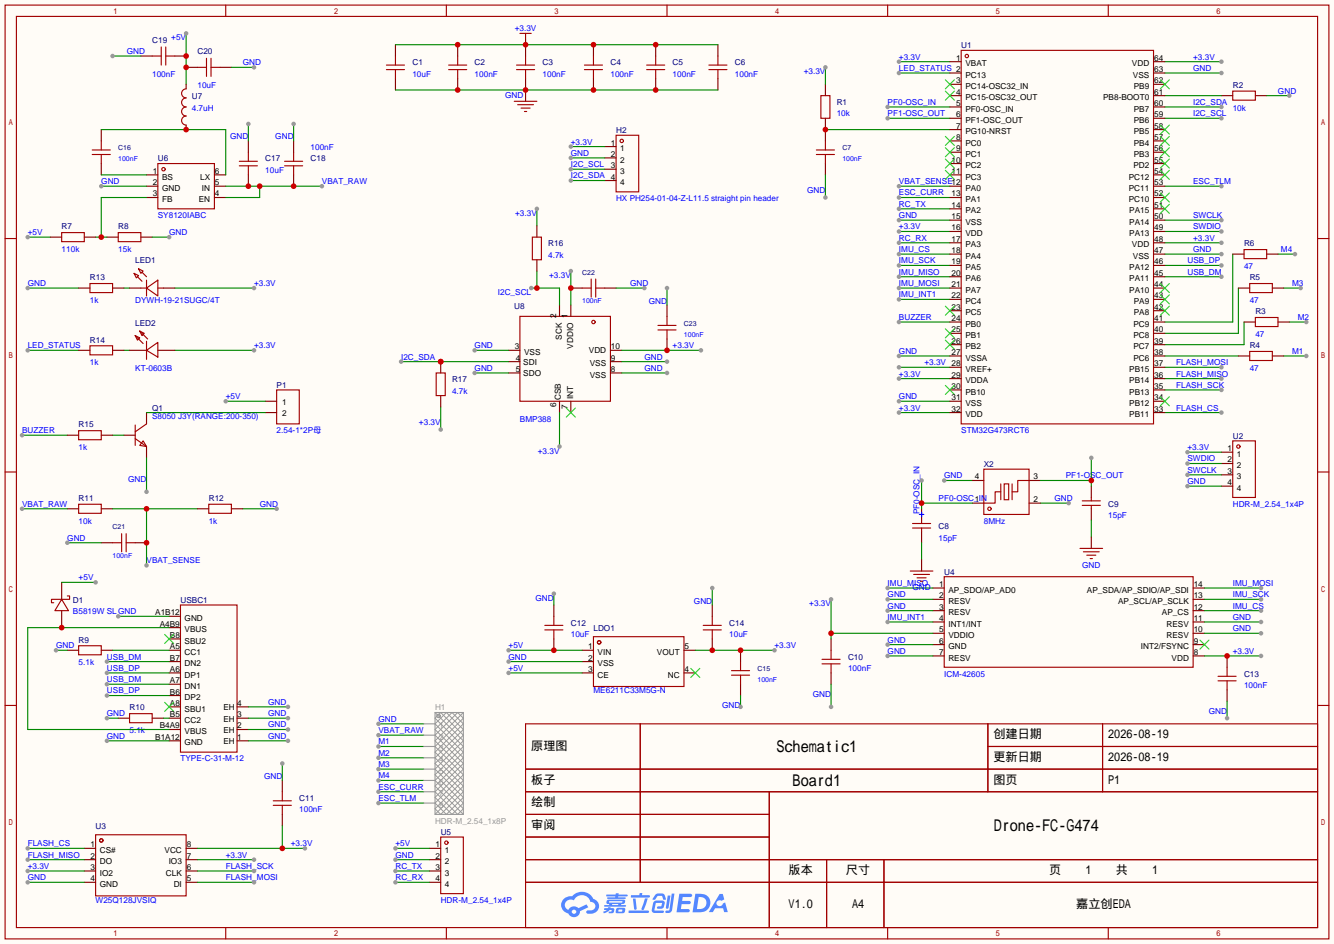
[picture p17: page 1]

原理图 | Schematic1 | 创建日期 | 2026-08-19

更新日期 | 2026-08-19

板子 | Board1 | 图页 | P1

绘制 | | Drone-FC-G474
审阅

V1.0 | A4 | 嘉立创EDA
