name718/drone/文档/docs-暂停/原理图/SCH_Main_2026-08-21.pdf

PA15 37 PA14-BOOT0 36 PA13 35 PA12[PA10] 34 PA11[PA9] 33 PA10 32 PA9 29 PA8 28 PA7 18 PA6 17 PA5 16 PA4 15 PA3 14 PA2 13 PA1 12 PA0 11

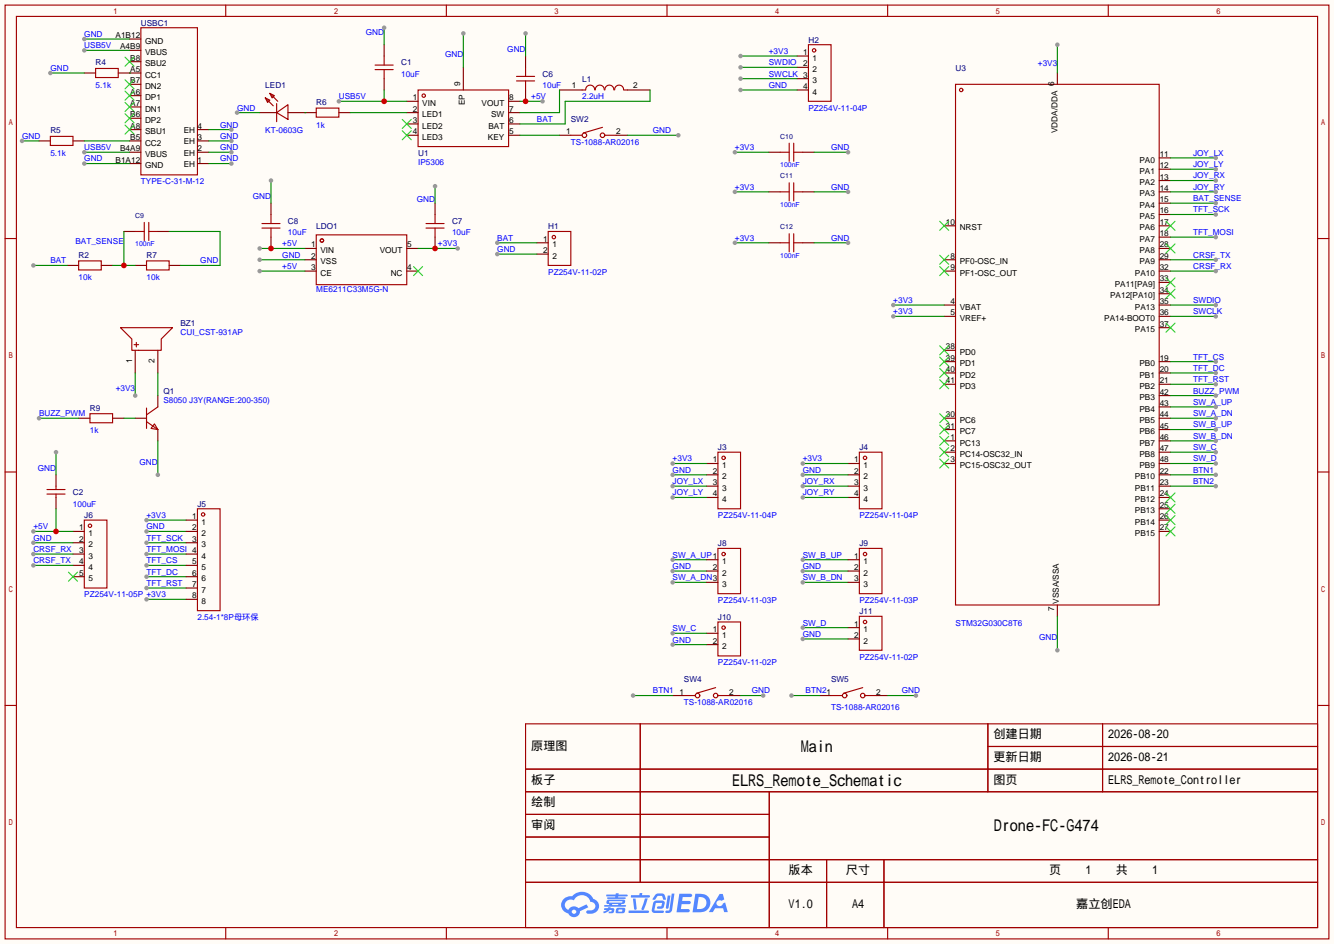
[picture p18: page 1]

原理图 | Main | 创建日期 | 2026-08-20

更新日期 | 2026-08-21

板子 | ELRS_Remote_Schematic | 图页 | ELRS_Remote_Controller

绘制 | | Drone-FC-G474
审阅

V1.0 | A4 | 嘉立创EDA
