name718/drone/firmware_chassis/Src/main.c

/**
 * @file main.c
 * @brief 自平衡小车底盘主控程序 (FreeRTOS 多任务版本)
 */

#include "attitude.h"
#include "bsp.h"
#include "bsp_spi.h"
#include "bsp_usart.h"
#include "control.h"
#include "encoder.h"
#include "icm42605.h"
#include "log.h"
#include "motor.h"

#include <stdlib.h>

// 引入 FreeRTOS 核心头文件
#include "FreeRTOS.h"
#include "task.h"

// --- 全局变量区增加轮速与体感走位状态缓存 ---
static volatile int16_t s_speed_left = 0;
static volatile int16_t s_speed_right = 0;
static volatile bool s_pos_reached = false;
static volatile uint8_t s_push_hold = 0;

// 全局姿态数据缓存
static Icm42605Data_t s_imu_data;

/**
 * @brief 核心姿态控制任务 (硬实时 100Hz，优先级：High = 5)
 */
static volatile int16_t s_current_pwm_left = 0;
static volatile int16_t s_current_pwm_right = 0;

static void Task_Control(void *pvParameters) {
    (void)pvParameters;
    TickType_t xLastWakeTime = xTaskGetTickCount();
    const TickType_t xPeriod = pdMS_TO_TICKS(10);  // 严格 10ms (100Hz)

    while (1) {
        vTaskDelayUntil(&xLastWakeTime, xPeriod);

        // 1. 高速读取六轴原始物理量
        icm42605_read_data(&s_imu_data);

        // 2. 100Hz 互补滤波姿态解算
        attitude_update(&s_imu_data, 0.01f);

        // 3. 100Hz 采样左右轮正交编码器增量 (脉冲数/10ms)
        encoder_get_speed((int16_t *)&s_speed_left, (int16_t *)&s_speed_right);

        // 4. 【控制模式】：双轮差速闭环速度 PID / 定距定角走位 / 安全急停
        int16_t cmd_speed = 0;
        int16_t cmd_yaw = 0;
        uint8_t cmd_mode = 0;
        bool is_online = bsp_usart2_get_cmd(&cmd_speed, &cmd_yaw, &cmd_mode);
        const Attitude_t *att = attitude_get();

        static uint8_t s_last_step_mode = 0;
        static int16_t s_last_cmd_speed = 0;
        static int16_t s_last_cmd_yaw = 0;

        // 外力推车感知：在电机无驱动指令时，车轮出现明显旋转脉冲
        if ((!is_online || cmd_mode == MOTION_MODE_BRAKE || (cmd_speed == 0 && cmd_yaw == 0)) &&
            (abs(s_speed_left) >= 3 || abs(s_speed_right) >= 3)) {
            s_push_hold = 20; // 维持 200ms
        } else if (s_push_hold > 0) {
            s_push_hold--;
        }

        if (!is_online || cmd_mode == MOTION_MODE_BRAKE || cmd_mode == MOTION_MODE_EMERGENCY ||
            (cmd_mode == MOTION_MODE_VELOCITY && cmd_speed == 0 && cmd_yaw == 0)) {
            // 上位机离线、待机或急停 -> 电机刹车，重置积分器
            motor_stop();
            s_current_pwm_left = 0;
            s_current_pwm_right = 0;
            control_diff_reset();
            s_pos_reached = false;
        } else if (cmd_mode == MOTION_MODE_VELOCITY) {
            // 模式 1: 双轮差速速度闭环 PID 巡航 (直行不跑偏，阻力自适应补偿)
            int16_t out_l = 0;
            int16_t out_r = 0;
            control_diff_pid_step(cmd_speed, cmd_yaw, s_speed_left, s_speed_right, &out_l, &out_r);
            s_current_pwm_left = out_l;
            s_current_pwm_right = out_r;
            motor_set_speed(s_current_pwm_left, s_current_pwm_right);
            s_pos_reached = false;
        } else if (cmd_mode == MOTION_MODE_STEP_MOVE) {
            // 模式 3: 精准闭环定距/定角走位 (前进 X mm，旋转 θ 0.1°)
            if (s_last_step_mode != MOTION_MODE_STEP_MOVE ||
                s_last_cmd_speed != cmd_speed || s_last_cmd_yaw != cmd_yaw) {
                // 收到新的定距走位指令，以当前航向角启动梯形规划
                control_step_move_start(cmd_speed, cmd_yaw, att->yaw);
                s_pos_reached = false;
            }

            int16_t out_l = 0;
            int16_t out_r = 0;
            s_pos_reached = control_step_move_update(s_speed_left, s_speed_right, att->yaw, &out_l, &out_r);
            s_current_pwm_left = out_l;
            s_current_pwm_right = out_r;
            motor_set_speed(s_current_pwm_left, s_current_pwm_right);
        }

        s_last_step_mode = cmd_mode;
        s_last_cmd_speed = cmd_speed;
        s_last_cmd_yaw = cmd_yaw;
    }
}

extern uint8_t _etext;
extern uint8_t _sdata;
extern uint8_t _edata;

/**
 * @brief 遥测与状态广播任务 (50Hz，优先级：Low = 2)
 */
static void Task_Telemetry(void *pvParameters) {
    (void)pvParameters;
    uint32_t led_count = 0;

    // 读取 STM32G4 芯片硬件级参数 (0x1FFF75E0 寄存器直读片上 Flash 容量)
    uint16_t reg_flash = *(const volatile uint16_t *)0x1FFF75E0;
    uint16_t flash_total = (reg_flash >= 64 && reg_flash <= 1024) ? reg_flash : 256;
    uint32_t flash_used_bytes = ((uint32_t)&_etext - 0x08000000) + ((uint32_t)&_edata - (uint32_t)&_sdata);
    uint16_t flash_used = (uint16_t)((flash_used_bytes + 1023) / 1024);

    while (1) {
        vTaskDelay(pdMS_TO_TICKS(20));  // 20ms (50Hz)

        if (++led_count >= 25) {
            led_count = 0;
            led_toggle();
        }

        // 1. 打包全维度跨芯片二进制状态遥测包 (0x55, 55 字节) 发往 ESP32-S3 大脑
        const Attitude_t *att = attitude_get();
        static uint8_t s_state_seq = 0;
        RobotStatePacket_t state_pkt;
        state_pkt.header = PROTOCOL_FRAME_HEADER_STATE;  // 0x55
        state_pkt.state_id = s_state_seq++;

        // --- 芯片硬件级档案 (Flash 存储 & SRAM 内存 & 96-Bit 硬件身份证号 UID) ---
        state_pkt.flash_total_kb = flash_total;
        state_pkt.flash_used_kb = flash_used;
        state_pkt.sram_total_kb = 112;  // STM32G473 SRAM1:80K + SRAM2:16K + SRAM3:16K = 112K
        state_pkt.sram_free_kb = (uint16_t)(xPortGetFreeHeapSize() / 1024);
        state_pkt.chip_uid[0] = *(const volatile uint32_t *)0x1FFF7590;
        state_pkt.chip_uid[1] = *(const volatile uint32_t *)0x1FFF7594;
        state_pkt.chip_uid[2] = *(const volatile uint32_t *)0x1FFF7598;

        state_pkt.pitch_angle = att->pitch;
        state_pkt.roll_angle = att->roll;
        state_pkt.pitch_rate = att->pitch_rate;
        state_pkt.acc_pitch = att->acc_pitch;

        // 左右轮测速换算 (脉冲数/10ms * 8.1 mm/s)
        state_pkt.left_speed = (int16_t)(((float)s_speed_left) * 8.1f);
        state_pkt.right_speed = (int16_t)(((float)s_speed_right) * 8.1f);
        state_pkt.left_pulse = s_speed_left;
        state_pkt.right_pulse = s_speed_right;
        state_pkt.left_pwm = s_current_pwm_left;
        state_pkt.right_pwm = s_current_pwm_right;
        state_pkt.battery_mv = 12100;  // 标称 12.1V 动力电池 (后续支持 ADC 采样)
        
        // 状态位：全量体感状态合成
        uint8_t flags = STATUS_FLAG_ONLINE;
        if (att->pitch > 35.0f || att->pitch < -35.0f || att->roll > 35.0f || att->roll < -35.0f) {
            flags |= STATUS_FLAG_FALL;       // 跌倒/倾覆报警标志
        }
        if (att->is_calibrated) {
            flags |= STATUS_FLAG_CALIBRATED; // IMU 静态零偏已就绪
        }
        if (s_current_pwm_left != 0 || s_current_pwm_right != 0) {
            flags |= STATUS_FLAG_MOTOR_RUN;  // 电机运转中
        }
        if (att->is_tapped) {
            flags |= STATUS_FLAG_TAP;        // 敲击桌面/拍头事件
        }
        if (att->is_picked_up) {
            flags |= STATUS_FLAG_PICKUP;     // 悬空离地/抱起事件
        }
        if (s_push_hold > 0) {
            flags |= STATUS_FLAG_PUSH;       // 外力推车事件
        }
        if (s_pos_reached) {
            flags |= STATUS_FLAG_POS_REACHED;// 闭环走位到达
        }
        state_pkt.status_flags = flags;

        // 计算 16 位累加和校验码
        uint16_t sum = 0;
        const uint8_t *p_data = (const uint8_t *)&state_pkt;
        size_t payload_len = sizeof(RobotStatePacket_t) - sizeof(uint16_t);
        for (size_t i = 0; i < payload_len; i++) {
            sum += p_data[i];
        }
        state_pkt.checksum = sum;

        // 通过 USART2 以 460.8k 高频推向 ESP32-S3 上位机
        bsp_usart2_send_bytes((const uint8_t *)&state_pkt, sizeof(state_pkt));
    }
}

int main(void) {
    // 1. 底层硬件基准初始化 (160MHz、串口、SPI)
    bsp_init();
    bsp_usart2_init(460800);

    LOG_I("系统", "========================================");
    LOG_I("系统", " STM32G473 底盘固件启动 (FreeRTOS)    ");
    LOG_I("系统", " 主频: 160MHz | 实时内核: FreeRTOS V10.5 ");
    LOG_I("系统", "========================================");

    bsp_spi1_init();
    delay_ms(50);

    // 2. 唤醒并校验 IMU 传感器
    if (icm42605_init()) {
        LOG_I("姿态", "ICM-42605 六轴陀螺仪初始化成功！");
        // 开机静止 1 秒自动校准陀螺仪零漂
        attitude_init();
    } else {
        LOG_E("姿态", "ICM-42605 六轴陀螺仪初始化失败！");
    }

    motor_init();
    LOG_I("电机", "TB6612 电机驱动硬件就绪");

    encoder_init();
    LOG_I("编码器", "TIM2(左) 与 TIM1(右) 硬件正交编码器初始化完成！");

    control_init();
    LOG_I("控制", "自平衡功能已休眠备用，底盘已进入【上位机全权差速直控模式】！");

    // 3. 创建 FreeRTOS 任务
    // 任务1: 控制任务 (栈大小 256 字 = 1024 字节，优先级 5)
    xTaskCreate(Task_Control, "Control", 256, NULL, 5, NULL);

    // 任务2: 遥测任务 (栈大小 256 字 = 1024 字节，优先级 2)
    xTaskCreate(Task_Telemetry, "Telemetry", 256, NULL, 2, NULL);

    LOG_I("系统", "正在启动 FreeRTOS 任务调度器...");

    // 4. 启动操作系统调度器 (正常情况下永远不会返回)
    vTaskStartScheduler();

    // 如果执行到这里，说明内存堆不足导致调度器启动失败
    while (1) {
        led_toggle();
        delay_ms(50);
    }

    return 0;
}
