name718/drone/firmware_chassis/Inc/attitude.h

/**
 * @file attitude.h
 * @brief 自平衡小车六轴姿态融合算法与零偏校准 (互补滤波)
 */
#ifndef ATTITUDE_H
#define ATTITUDE_H

#include <stdbool.h>
#include <stdint.h>

#include "icm42605.h"

#ifdef __cplusplus
extern "C" {
#endif

/**
 * @brief 姿态解算核心数据结构体
 */
typedef struct {
    float pitch;         // 核心俯仰角 (单位: 度 deg，小车水平为 0)
    float pitch_rate;    // 俯仰角速度 (单位: deg/s，扣除零偏)
    float roll;          // 横滚角 (单位: deg)
    float acc_pitch;     // 加速度计纯静态角度
    float acc_mag;       // 三轴加速度矢量模长 (单位: g, 静止时约为 1.0g)
    float yaw;           // 航向角积分 (单位: 度 deg, 扣除 Z 轴零偏连续积分)
    float gyro_bias_x;   // X 轴陀螺仪静态零偏
    float gyro_bias_y;   // Y 轴陀螺仪静态零偏
    float gyro_bias_z;   // Z 轴陀螺仪静态零偏
    bool is_calibrated;  // 零偏校准是否完成
    bool is_tapped;      // 敲击/拍打桌面突发事件 (保持 150ms 脉冲)
    bool is_picked_up;   // 被抱起/离地悬空状态
} Attitude_t;

/**
 * @brief 初始化姿态解算器，并执行陀螺仪静态零偏校准
 * @note  调用时请将小车静止平放在桌面上 1~2 秒！
 */
void attitude_init(void);

/**
 * @brief 100Hz 周期姿态融合滤波更新
 * @param imu_data 传感器六轴物理量
 * @param dt 采样周期 (单位: 秒，100Hz 对应 0.01f)
 */
void attitude_update(const Icm42605Data_t *imu_data, float dt);

/**
 * @brief 获取当前姿态解算结果指针
 */
const Attitude_t *attitude_get(void);

#ifdef __cplusplus
}
#endif

#endif /* ATTITUDE_H */
