name718/drone/shared/ui/dizzy_points.hpp

// 原蚊香线a=0.5f; a<4.8*pi; a+=0.22f, r=a*2.3f的固定几何，单位1/256像素。
// 预先计算r*cos(a)、r*sin(a)，每帧只求一次旋转角的sin/cos，再用整数旋转。
// 表存放Flash中；Q8量化误差小于1/256像素，避免Cortex-M3逐点计算浮点三角函数。
#pragma once
#include <cstdint>
inline constexpr int16_t DIZZY_POINTS[][2] = {
    {258, 141},
    {319, 280},
    {326, 447},
    {273, 626},
    {154, 798},
    {-28, 942},
    {-264, 1039},
    {-543, 1071},
    {-846, 1027},
    {-1152, 897},
    {-1437, 679},
    {-1677, 378},
    {-1849, 3},
    {-1931, -429},
    {-1909, -895},
    {-1770, -1369},
    {-1511, -1822},
    {-1136, -2223},
    {-656, -2543},
    {-89, -2754},
    {538, -2834},
    {1195, -2768},
    {1846, -2545},
    {2454, -2166},
    {2981, -1641},
    {3392, -987},
    {3655, -231},
    {3745, 592},
    {3646, 1443},
    {3351, 2277},
    {2862, 3047},
    {2194, 3710},
    {1371, 4223},
    {429, 4549},
    {-591, 4661},
    {-1637, 4542},
    {-2659, 4185},
    {-3599, 3595},
    {-4407, 2792},
    {-5032, 1807},
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
};
