name718/drone/(commit log)

2026-08-15 feat: 需求与器件选型
2026-08-16 feat: 建模
    [lower_frame-V5.stl]
2026-08-18 feat: 完成 pcb 的制作
2026-08-21 feat: 整理文档
    [lower_frame-V5.stl]
2026-08-25 feat: 更新物料
    [DXF_PCB2_2026-08-25_AutoCAD2007.dxf]
2026-08-25 feat: 更新外设清单
2026-08-25 feat: 更新
2026-08-25 feat: add desktop self-balancing robot docs, purchase list, and 3D cad design
    [robot_chassis.scad]
2026-08-25 docs: add 3d printing end-to-end workflow guide
2026-08-25 fix: adjust robot clearances, resolve tire and standoff intersections in blender
2026-08-25 feat: optimize 3d robot wheels, proportions, and 3/4 isometric perspective in blender
2026-08-25 docs: lock in 18650 battery box with Type-C 2S charging solution in purchase list
2026-08-27 feat: 完成平衡车的原理图
    [DXF_PCB2_2026-08-25_AutoCAD2007.dxf, robot_chassis.scad]
2026-08-27 docs: add complete V1 schematic specification and pin-level netlist document
2026-08-28 feat: 更新文档
    [v1_open_frame.blend, v1_open_frame.scad, v1_open_frame_parts.stl]
2026-08-28 feat: 调整工作目录
    [lower_frame-V5.stl, v1_open_frame.blend, v1_open_frame.scad, v1_open_frame_parts.stl, 机械尺寸草模.blend, 机械成品方案-V2.blend, 机械成品方案-V4.blend, 机械成品方案-V5.blend]
2026-08-28 feat: init项目
2026-08-28 feat: 测试代码
2026-08-29 feat:烧录脚本
2026-08-29 feat: 工程化
2026-08-29 feat: I2C 封装
2026-08-29 feat: 人机交互
2026-08-29 feat: 整理笔记
2026-08-29 feat: 声音播放
2026-08-29 feat: 麦克风
2026-08-29 feat: uart 串口通信
2026-08-29 feat: 总结文档
2026-08-29 feat: 重构
2026-08-29 feat: wifi配置
2026-09-13 记录接线方式
2026-09-19 feat: 完成下位机的连接
2026-09-19 build(chassis): 增加 Docker 交叉编译与一键烧录脚本
2026-09-19 feat(chassis): 搭建 STM32G473 CMSIS 核心库与启动引导工程
2026-09-19 feat(bsp): 实现 160MHz 主频时钟、SysTick 滴答与 SPI1 硬件驱动
2026-09-19 feat(chassis): 实现 ICM-42605 六轴姿态驱动与 100Hz 主控循环
2026-09-19 feat: 增加日志
2026-09-19 fix(imu): 适配华轩阳 ICM-42605-HXY 寄存器映射并打通六轴数据闭环
    - 根据官方手册更新寄存器协议，修正芯片 ID 寄存器地址为 0x01 (识别码 0x6A)
    - 修正整机软复位逻辑 (0x4A 写入 0xA5) 与核心电源管理唤醒 (0x7D 写入 0x0E 开启三轴起振)
    - 重构六轴数据突发读取起始地址为 0x0C，彻底解决因误读 0x1F FIFO 状态位导致的 4.00g 常数假死问题
    - 优化 100Hz 高频主控节拍与 5Hz 串口日志等宽对齐排版
    - 归档官方数据手册至文档/资料/ICM.pdf
    [bsp_spi.c, icm42605.c, icm42605.h, log.h, main.c]
2026-09-25 feat: 接入 freeRTOS
2026-09-25 feat: task 任务
2026-09-25 feat(chassis): 实现六轴互补滤波姿态解算与开机陀螺仪零漂校准
    - 实现 attitude 姿态解算模块，基于一阶互补滤波融合加速度计与陀螺仪
    - 增加开机 1 秒自动采样校准陀螺仪静态零偏，彻底消灭积分累加漂移
    - 优化 CMakeLists.txt 链接数学库 libm
    - 在 FreeRTOS Task_Control 中以 100Hz 硬实时执行姿态更新，Task_Telemetry 50Hz 绘图
2026-09-25 feat(chassis): 实现 TB6612 电机驱动与 TIM1/TIM2 硬件正交编码器测速闭环
2026-10-02 feat: 添加测试代码
2026-10-02 feat: 上位机清空
2026-10-02 feat: 设置高速波特率
2026-10-03 feat: esp32基础架构
2026-10-03 feat: 更新日志为中文
2026-10-05 feat: 下位机
2026-10-05 feat: 接入 wifi
2026-10-05 feat(web): 新增嵌入式 Web 控制台与 WebSocket 全双工流式服务
    - 开启 ESP-IDF HTTP 服务器的 WebSocket (CONFIG_HTTPD_WS_SUPPORT=y) 支持
    - 实现基于 Flash 零文件系统内嵌的赛博朋克风单页管理后台 (web/index.html)
    - 实现 WebServer 服务单例，支持 1Hz 遥测指标主动广播与双向实时指令交互
2026-10-05 feat(display): 实现 1.8寸 ST7735 竖屏驱动与赛博拟人表情引擎 FaceEngine
    - 驱动层实现 4KB DMA 连续分片推流与手动 CS 锁存，突破 ESP32-S3 32KB DMA 寄存器上限根治花屏
    - 适配 128x160 竖屏几何布局，实现 33 FPS 独立渲染线程与图形基元绘制
    - 算法层实现赛博电子眼自然呼吸、2.0s~4.5s 随机非阻塞眨眼与多情绪状态机
2026-10-05 feat(gimbal): 实现二自由度头部云台平滑加减速控制与实机中位校准
    - 硬件层基于 ESP32-S3 硬件 LEDC (50Hz, 14-bit 分辨率) 实现 SG90 舵机精确角度控制
    - 控制层引入一阶低通指数平滑滤波，消除机械冲击与电源瞬态压降
    - 校准实机归中角度 (水平 29°, 俯仰 0°)，实现点头 (nod) 与摇头 (shake) 拟人化手势状态机
2026-10-05 feat(core): 大脑中枢整合 Web、视觉与云台调度并更新全局配置
    - board_config.hpp 集中定义 ST7735S (SPI2) 与 SG90 (LEDC) 引脚及 FreeRTOS 任务优先级
    - CMakeLists.txt 注册 display/gimbal 源文件并引入 esp_driver_ledc/esp_driver_spi 等组件依赖
    - RobotBrain 外观单例统一初始化与调度跨核后台任务 (Core 0 处理网络/Web，Core 1 专职视觉/底盘/动作)
2026-10-05 feat(audio): 实现 MAX98357A 扬声器与 INMP441 麦克风声学服务及 Web 联动
    - 引脚中心化配置：在 board_config.hpp 中统一配置 I2S0/I2S1 引脚及采样率
    - 硬件驱动层：
    * speaker_driver: 纯数学正弦波合成器、5ms 软包络防破音算法、支持开机和弦/提示音/警报/PCM 流
    * mic_driver: 32位槽位 24位有效 PCM 录音与实时 RMS 均方根声学能量计算
    - 业务服务层：
    * audio_service: 单例纳管 Core 0 音频监测后台任务 (10Hz)，集成至 RobotBrain 生命周期
    - 前端控制与全双工联动：
    * Web 控制台新增【声学系统】卡片，支持音效触发、音量调节与麦克风实时 VU 动态跳动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
2026-10-05 feat(interaction): 实现声-画-机拟人多模态自主交互引擎与生命感状态机
    - 核心架构：新增 InteractionService 单例中枢，统一协调眼睛 (FaceEngine)、脖子 (GimbalService)、嘴巴 (SpeakerDriver) 与耳朵 (MicDriver)
    - 自主行为状态机：
    * 声音感知唤醒：麦克风能量超阈值瞬时触发好奇大眼 + 仰头探寻 + 提示短音
    * 发呆生命微动：空闲 8~14 秒随机在水平与俯仰方向微调视线，模拟小宠物生命感
    * 困倦打盹休眠：连续 30 秒无交互自动闭眼垂头打盹
    * 人机共融：用户手动遥控介入时瞬间打断休眠并刷新空闲计时器
    - Web 控制中枢联动：新增【拟人自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
2026-10-05 feat(chassis): 下位机停用自平衡转为上位机全权差速直控与安全看门狗
    - 协议解包：引入 robot_protocol.h，USART2 开启 RXNE 硬件接收中断，基于有限状态机 (FSM) 实时解析 0xAA 控制帧
    - 运动模式切换：在 100Hz Task_Control 中停用倒立摆自平衡 PID，完全由上位机接管差速控制与死区补偿
    - 安全防护：增加 500ms 通信看门狗，上位机掉线或急停瞬间锁死电机
    - 实机验证通过，底盘遥控平稳静止、转向无自激
2026-10-05 feat(display): 扩充赛博拟人表情库、声波律动视听频谱与特技跳舞秀
    - 图形驱动层 (st7735):
    * 新增粉红/品红/暖橙/亮黄/紫色等丰富赛博调色板
    * 扩展 Bresenham 画线 (drawLine)、快速横竖线及实心画圆 (fillCircle) 核心图元
    - 拟人表情引擎 (face_engine):
    * 新增 4 款高表现力拟人表情：爱心心动 (LOVE, 带 60BPM 脉动)、生气怒眉 (ANGRY)、疑惑挑眉 (CONFUSED)、眩晕转圈 (DIZZY, 33FPS 旋转阿基米德螺线)
    * 新增屏幕底部 9 柱对称赛博动态声浪频谱 (Soundwave Visualizer)，实时结合 INMP441 声能跳跃变色
    - 多模态交互中枢 (interaction_service):
    * 接入各表情的多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
2026-10-05 refactor: 解耦底盘与云台控制，完善双芯片全维度硬件遥测，重构移动端自适应控制台并清除全项目图标
    - 控制解耦: 移除底盘移动指令对云台方向的自动引导，实现底盘与云台完全独立控制
    - 协议扩展: 跨芯片协议升级为 55 字节，新增 STM32 96-Bit 硬件 UID、Flash/SRAM 容量与占用、FreeRTOS 堆余、完整姿态角与电机 PWM
    - 云台遥测: 增加云台物理偏航与俯仰角度实时获取并在 Web 端展示
    - 前端重构: Web 控制台升级为四标签移动端原生式布局(驾驶座舱、双芯遥测、拟人交互、AI智脑)，支持固定视口与比例触控
    - 图标清理: 全面清除工程源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
2026-10-06 feat(ai): 实现云端多模态大模型语音交互中枢、全时音频环形流控与回声抑制
    1. 接入阿里云百炼 DashScope 实时语音识别 (paraformer-realtime-v2) 与语音合成 (cosyvoice-v1) WebSocket 双全工链路。
    2. 引入极速低延迟大模型 qwen-turbo，实现端到端拟人问答、动作与表情标签联动派发。
    3. 实现 64KB PSRAM 全时态单生产者音频环形缓冲区，保全唤醒词首字并消除 I2S 硬件通道并发冲突。
    4. 在功放驱动层引入软件回声抑制 (Software AEC) 与 350ms 空间混响防护，杜绝机器人自发声自激打断。
    5. 配置 mbedTLS 外部 PSRAM 动态加解密内存，彻底解决并发 TLS 握手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
    [partitions.csv]
2026-10-06 feat: 增加注释
2026-10-11 feat(core): 完善大模型流式语音交互、扩充多模态拟人动作库与底盘差速遥测系统
    1. 语音中枢: 修复 DashScope CosyVoice WebSocket 全双工流式协议交互流程，实现云端音频流直通 I2S 边收边
    播。
    2. 拟人行为: 扩展 CURIOUS(好奇探脑)、SHY(害羞娇憨)、PATROL(警惕巡视)、EXCITED(兴奋雀跃) 拟人连招与空闲自发
    微动作。
    3. 底盘控制: 解耦并模块化自平衡算法，底盘主控保持安全差速直控模式，杜绝物理受限导致的失控跑车。
    4. 遥测诊断: 新增 SWD 物理零点微调脚本与 WebSocket 姿态动力实时监控工具。
2026-10-11 feat(cad): 接入 CadQuery 参数化建模引擎并导出底盘核心骨架与元器件 STEP 模型
    1. 接入 CadQuery 2.8 与 OpenCASCADE 工业级几何内核，建立参数化 Code-to-CAD 工作流。
    2. 建模并导出 drone_chassis_core.step 与 .stl：包含左右 N20 双电机精密卡槽、3S 锂电池下沉沉降仓、魔术贴扎带通孔、尾部万向滚珠支架与上层电气安装立柱。
    3. 建模并导出 drone_mockup_components.step：包含 1:1 标准元器件占位体（电机、车轮、电池、1.8寸彩屏、云台舵机），供直接导入 Shapr3D 无损编辑外观与曲面造型。
2026-10-16 feat: 删除模型
2026-10-16 feat: 2.0升级方案
2026-10-17 feat: 添加尺寸
2026-10-18 提取共享界面与头部协议
2026-10-18 新增C8头部控制固件
2026-10-18 接入Luckfox串口桥接
2026-10-18 迁移ESP屏幕与云台控制
2026-10-18 接入摄像头预览并修复色彩
2026-10-18 补充接线文档与联调测试
